manfred-hofmann/Wortuhr_ESP8266/Bau/Bau_Wortuhr_260x260.pdf

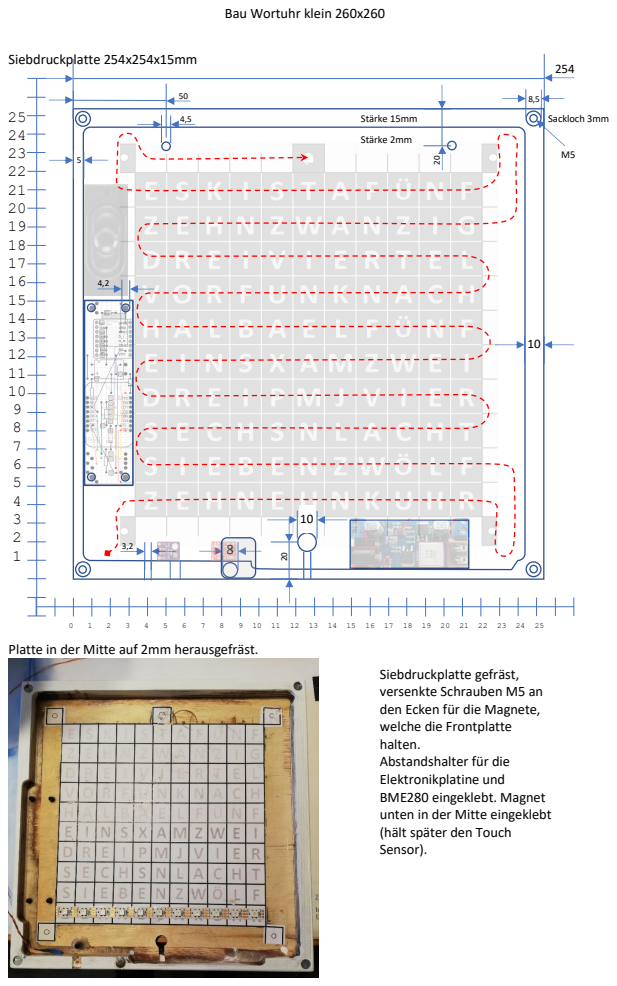
[picture p22: page 1]
Siebdruckplatte 254x254x15mm; Stärke 2mm; Stärke 15mm; Sackloch 3mm

Bau Wortuhr klein 260x260

Platte in der Mitte auf 2mm herausgefräst.

Siebdruckplatte gefräst,
versenkte Schrauben M5 an
den Ecken für die Magnete,
welche die Frontplatte
halten.
Abstandshalter für die
Elektronikplatine und
BME280 eingeklebt. Magnet
unten in der Mitte eingeklebt
(hält später den Touch
Sensor).

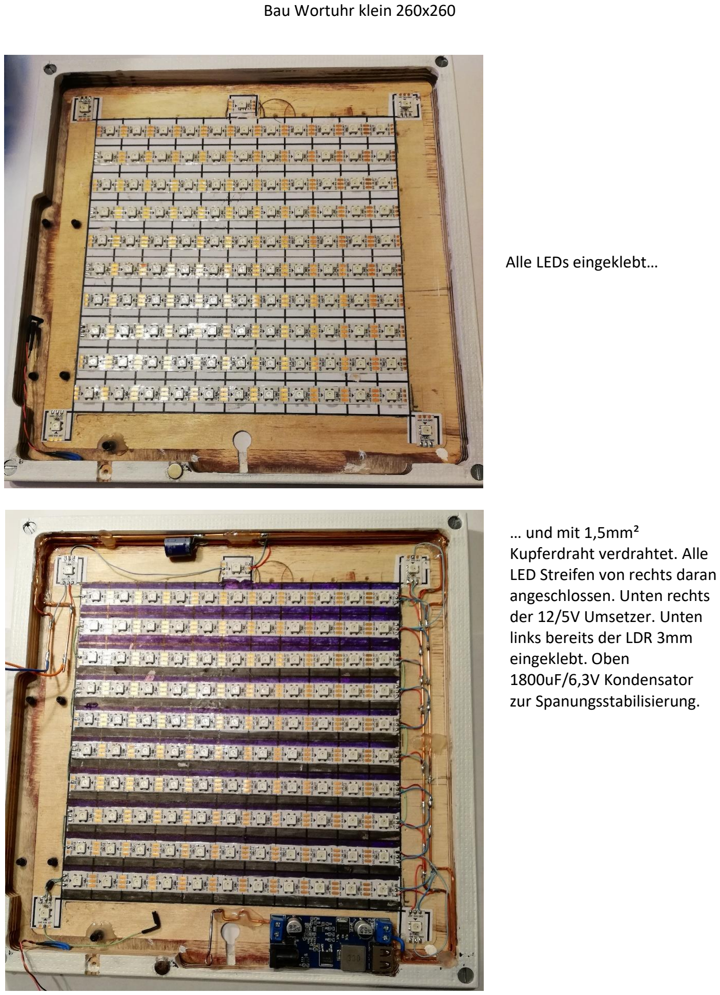
[picture p23: page 2]

Alle LEDs eingeklebt…

… und mit 1,5mm²
Kupferdraht verdrahtet. Alle LED Streifen von rechts daran angeschlossen. Unten rechts der 12/5V Umsetzer. Unten
links bereits der LDR 3mm
eingeklebt. Oben
1800uF/6,3V Kondensator
zur Spanungsstabilisierung.

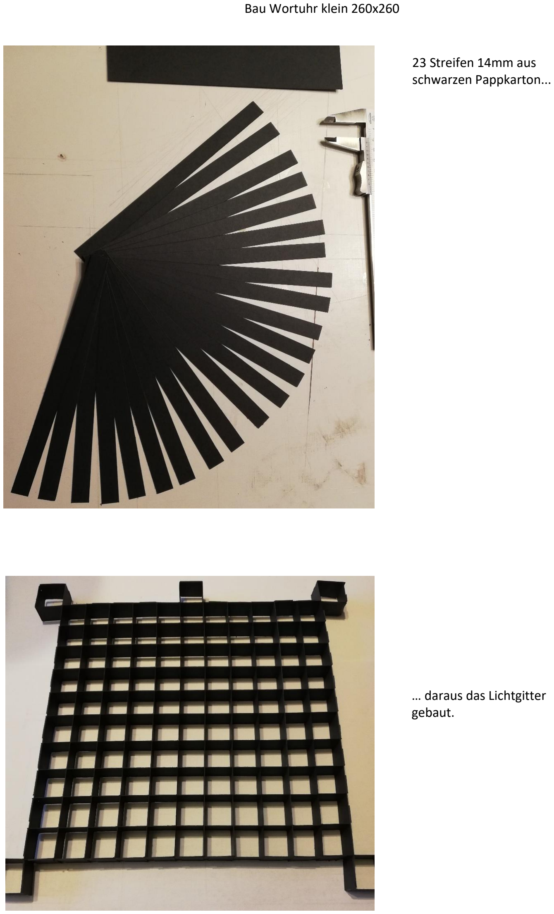
[picture p24: page 3]

23 Streifen 14mm aus
schwarzen Pappkarton...

… daraus das Lichtgitter
gebaut.

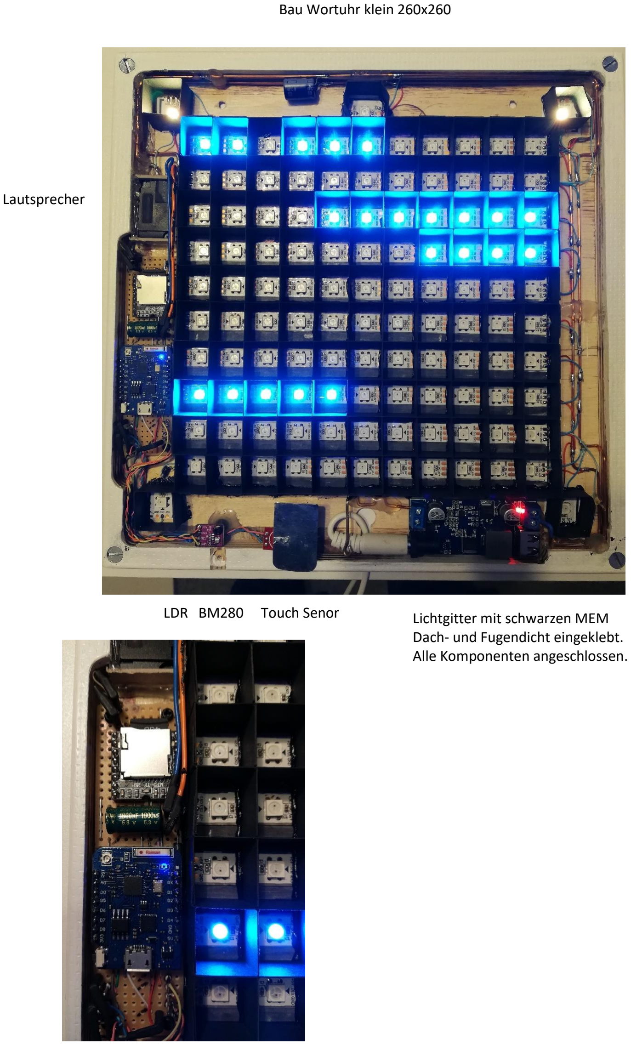
[picture p25: page 4]

Lichtgitter mit schwarzen MEM Dach- und Fugendicht eingeklebt. Alle Komponenten angeschlossen.

Lautsprecher

LDR BM280 Touch Senor

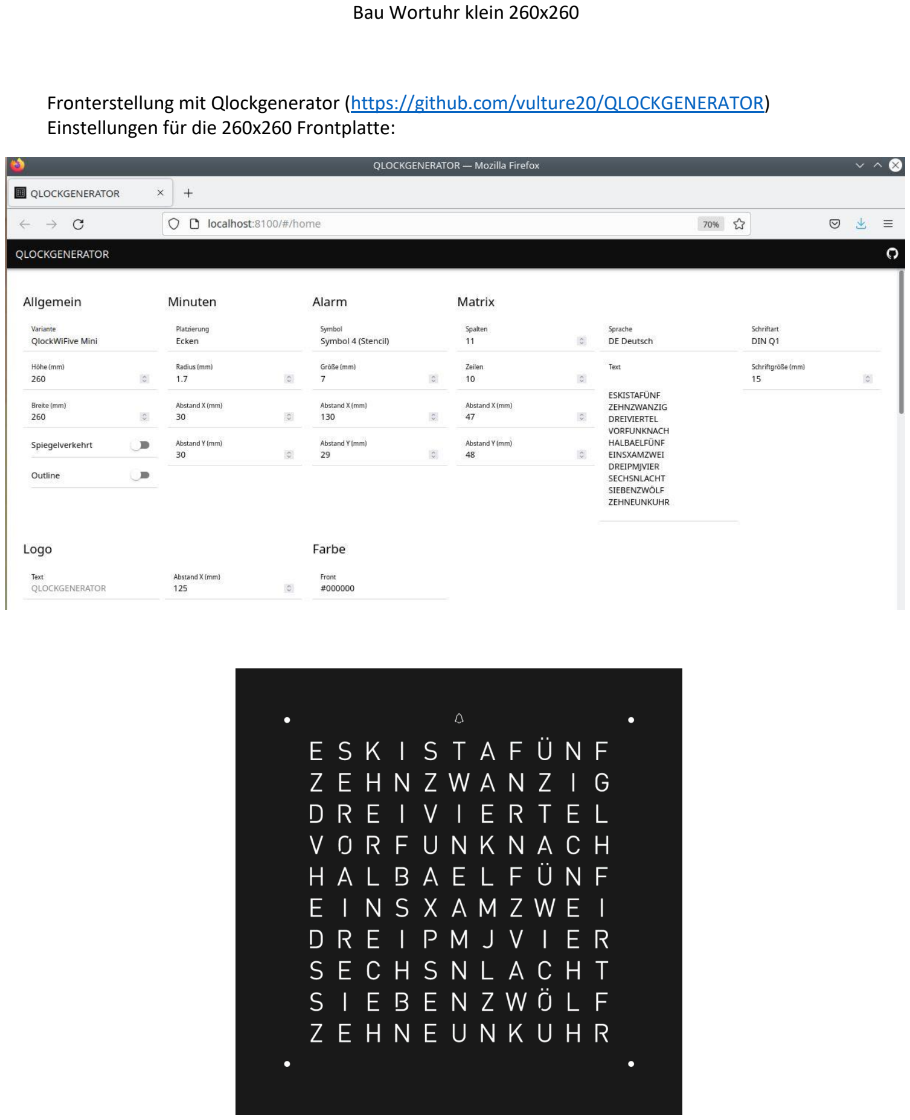
[picture p26: page 5]

Fronterstellung mit Qlockgenerator (https://github.com/vulture20/QLOCKGENERATOR) Einstellungen für die 260x260 Frontplatte:

Magnete an den Ecken der Rückseite der Frontplatte geklebt. Forder- und Rückseite matt lackiert. Transparentpapier mit Sprühkleber auf die Rückseite geklebt.

Fertige Uhr:

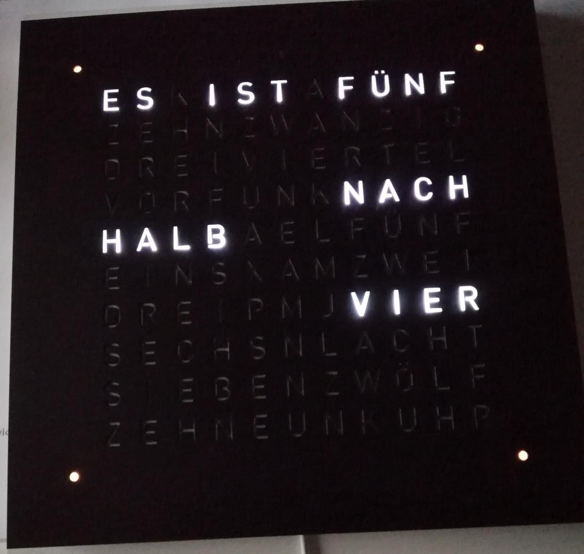
[picture p27: figure]

Bauteilliste:

Nr | Artikel | Web | Einzelpreis | Menge | Preis
1 | JZK® 24V/ 12V bis 5V 5A Power Buck Modul DC-DC Step Down Netzteil Konverter Board | Amazon (https://www.amazon.de/Power-Modul-DC-DC-Netzteil-Konverter/dp/B071ZRXKJY) | 6,59 | 1,00 | 6,59
2 | Intenso microSDHC 8GB Class 10 Speicherkarte | Amazon (https://www.amazon.de/Intenso-Micro-Class-Speicherkarte-SD-Adapter/dp/B008RDCCFS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) | 3,39 | 1,00 | 3,39
3 | Fotowiderstand PFW351, 3 mm, 5 Stück | Amazon (https://www.amazon.de/Pollin-Fotowiderstand-PFW351-St%C3%BCck/dp/B00H8O5MAE) | 1,49 | 0,20 | 0,30
4 | 50 Blatt Weiß Transparentpapier 90g DIN A4 210x297mm Golden Star, Pauspapier zum Bedrucken | Amazon (https://www.amazon.de/gp/product/B07N86TL8H/ref=ppx_yo_dt_b_asin_title_o09_s00) | 7,00 | 0,04 | 0,28
5 | Fotokarton, Bastelkarton schwarz, 50 Blatt, DIN A4, hochwertige Qualität, 300 g/m² | Amazon (https://www.amazon.de/dp/B01N0DPHI1/ref=pe_27091401_487024491_TE_item) | 8,95 | 0,04 | 0,36
6 | MEM Dach- und Fugendicht, Lösemittelfreie Bitumenmasse, Schwarz, 300 g | Amazon (https://www.amazon.de/gp/product/B002KLV98O/ref=ppx_yo_dt_b_asin_title_o00_s00) | 5,79 | 0,05 | 0,29
7 | Yizhet 50 Stück Magnete Ultra Magnet Supermagnete Haushaltsmagnete 8x3 mm | Amazon (https://www.amazon.de/gp/product/B074C79DJS/ref=ppx_yo_dt_b_search_asin_title?th=1) | 9,59 | 0,10 | 0,96
8 | DollaTek 5PCS TTP223 Touch-Key-Modul | Amazon (https://www.amazon.de/DollaTek-Touch-Key-Modul-Kapazitiv-Einstellbare-Self-Lock/dp/B07DK3DFR2) | 4,99 | 0,20 | 1,00
9 | Schaltnetzteil, Telekom, DA-24R12-AAAA,12V/2A, weiß oder Ähnliches | Pollin (https://www.pollin.de/p/schaltnetzteil-telekom-da-24r12-aaaa-12v-2a-weiss-352355) | 2,65 | 1,00 | 2,65
10 | Euro-Netzkabel mit Doppelnutkupplung, weiß, 1,5m | Pollin (https://www.pollin.de/p/euro-netzkabel-mit-doppelnutkupplung-weiss-1-5m-b-ware-563753) | 0,95 | 1,00 | 0,95
11 | Streifenraster-Platine, FR4, Epoxyd, 160x100 mm | Pollin (https://www.pollin.de/p/streifenraster-platine-fr4-epoxyd-160x100-mm-442501) | 3,85 | 0,20 | 0,77
12 | Lautsprecher-Set, L/R, 4 Ohm, 2,5 W oder alter Handylautsprecher | Pollin (https://www.pollin.de/p/lautsprecher-set-l-r-4-ohm-2-5-w-aus-laptop-641240) | 0,75 | 0,50 | 0,38
13 | Elektrolytkondensator, 1,8mF, 6,3V 10x16mm | Pollin (https://www.pollin.de/p/elektrolytkondensator-1-8mf-6-3v-210885) | 0,30 | 2,00 | 0,60
14 | Metallschicht-Widerstand, 0,6 W, 4,7kΩ, 1 % | Pollin (https://www.pollin.de/p/metallschicht-widerstand-0-6-w-4-7ko-1-221177) | 0,07 | 2,00 | 0,14
15 | Metallschicht-Widerstand, 0,6 W, 2,2kΩ, 1 % | Pollin (https://www.pollin.de/p/metallschicht-widerstand-0-6-w-2-2ko-1-221170) | 0,07 | 2,00 | 0,14
16 | Metallschicht-Widerstand, 0,6 W, 3,9 Ω, 1 % | Pollin (https://www.pollin.de/p/metallschicht-widerstand-0-6-w-3-9-o-1-221126) | 0,07 | 1,00 | 0,07
17 | Diode 1N4007, axial | Pollin (https://www.pollin.de/p/diode-1n4007-axial-140020) | 0,02 | 2,00 | 0,04
18 | Kupferdraht 0,3mm versilbert 10m | Pollin (https://www.pollin.de/p/kupferdraht-versilbert-560040) | 0,80 | 0,04 | 0,03
19 | Mini MP3 Modul DFPlayer Mini Besser Leiterkartenpiraten Player | AliExpress (https://de.aliexpress.com/item/32669547044.html?spm=a2g0o.9042311.0.0.43384c4dLeTun8) Leiterk (https://www.leiterkartenpiraten.de/produkt/lkp-player/) | 1,29 8,00 | 1,00 1,00 | 1,29 8,00
20 | WeMos D1 Mini ESP8266 WIFI Modul Entwicklung Bord Pro 16M Bytes | AliExpress (https://de.aliexpress.com/item/32669779651.html?spm=a2g0o.9042311.0.0.43384c4dLeTun8) | 6,48 | 1,00 | 6,48
21 | GY-BME280 Digital Sensor Temperatur Feuchtigkeit Luftdruck Sensor | AliExpress (https://de.aliexpress.com/item/32898592482.html?spm=a2g0o.9042311.0.0.43384c4dLeTun8) | 7,91 | 1,00 | 7,91
22 | 4m WS2812B RGB Led Streifen Schwarz PCB 5V 4m 60 IP30 | AliExpress (https://de.aliexpress.com/item/2036819167.html?spm=a2g0o.9042311.0.0.43384c4dLeTun8) | 15,42 | 0,50 | 7,71
23 | Siebdruckplatte 254x254x15 | Baumarkt | 6,00 | 1,00 | 6,00
24 | Frontplatte Acrylglas GS Präzisison schwarz, opak Stärke 1 mm 790 x 384 mm = 3 x Front | Formulor | 118,77 | 0,33 | 39,59
25 | Kleinteile (Schrauben, Sprühkleber, Farbe, 1,2m Kupferdraht 1,5mm² u.s.w) | Baumarkt | 12,00 | 1,00 | 12,00
Summe: | 99,91
