manfred-hofmann/Wortuhr_ESP8266/pic/spiffs2.JPG

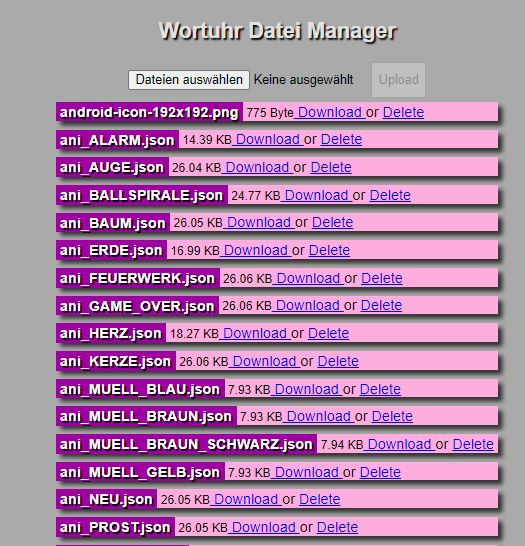
pic/spiffs2.JPG
