manfred-hofmann/Wortuhr_ESP8266/src/data/web/web_01na.png

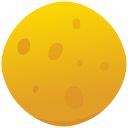
src/data/web/web_01na.png
