manfred-hofmann/Wortuhr_ESP8266/src/data/web/web_02na.png

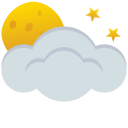
src/data/web/web_02na.png
