manfred-hofmann/Wortuhr_ESP8266/src/data/web/web_10na.png

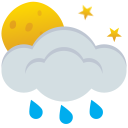
src/data/web/web_10na.png
