manfred-hofmann/Wortuhr_ESP8266/src/data/web/web_10nb.png

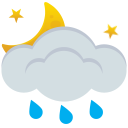
src/data/web/web_10nb.png
