manfred-hofmann/Wortuhr_ESP8266/src/data/web/web_11.png

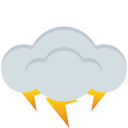
src/data/web/web_11.png
