manfred-hofmann/Wortuhr_ESP8266/(threads)

Thread 5 (2022-01-02):

Keine Daten vom BME_280

Phi2ipp, 2022-01-02:
Hallo,

ich verwende den 6 Pin (VCC, GND, SCL, SDA, CSB, SDO) BME 280 Sensor.
Diesen habe ich wie im Schaltplan angeschlossen, aber leider spuckt er keine Daten aus.
Auf der Info-Seite des ESP8266 werden es immer mehr "Error (BME): 60"

Kannst du mir hier weiterhelfen?

manfred-hofmann, 2022-01-03:
Ich glaube du musst hier noch zusätzlich den CSB Pin auf VCC (3,3V) legen.

Phi2ipp, 2022-01-03:
Das bringt leider keine Veränderung.
Wird wohl der Sensor defekt sein.

manfred-hofmann, 2022-01-03:
Evtl. stimmt die Adresse auch nicht. Schau mal ins Datenblatt. Mit SD0 wird zwischen 0x76 und 0x77 umgeschaltet. Ich glaub für die default Adresse des BME280 muss der SD0 auf Masse liegen. Oder mach mal mit einem Scan Programm einen I2c scan, ob dein BME280 gefunden wird.

Phi2ipp, 2022-01-03:
Der BME280 wird nicht im I2C gefunden. Ich vermuter er ist defekt.
Werde mir einen neuen besorgen und es noch mal testen.

manfred-hofmann, 2022-01-03:
👍

Closed 2022-01-03.

Thread 7 (2022-02-28):

16x16 LED Matrix support?

bmk666, 2022-02-28:
Hi Manfred,

erst mal vielen dank für das tolle Projekt!

Wäre es Möglich eine fertige 16x16 LED Matrix zu verwenden?

z.B. [Link](https://www.amazon.de/HER-WS2812B-Flexible-Individually-addressable/dp/B08DVBGRRL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)

Das würde das Bauen einer solchen Uhr extrem vereinfachen!

Und man könnte vielleicht die zusätzlichen Pixel für Sekunden nehmen wie z.B. bei dem Projekt:
[Link](https://www.thingiverse.com/thing:5073594)

Danke und viele Grüße,

Sascha

manfred-hofmann, 2022-02-28:
Hallo Sascha,
möglich ist viel.
Jedoch ist die 16x16 Matrix schon sehr klein.
Du musst einfach die LED Matrix in LedDriver.cpp entsprechend anpassen. Ist unten in der Readme auf der Hauptseite erklärt.
Ein "Sekundenzeiger" ist aktuell nicht vorgesehen.
Gruß
Manfred

bmk666, 2022-02-28:
Hi,

Ja von wegen der Größe ist es mehr was für den Schreibtisch, nicht für die Wand!
Nochmals danke!

Grüße,
Sascha

Closed 2022-02-28.

Thread 8 (2022-04-15):

RTC Modul

LeifGitHub, 2022-04-15:
Ein wirklich unglaubliches Projekt. Hast du bereits über die Integration einer RealTimeClock nachgedacht, sodass man die Uhr nur zum aufsetzten mit WiFi betreiben muss?

manfred-hofmann, 2022-04-15:
Ohne WiFi macht die Uhr keinen Sinn, da dann das Web frontend und open weather nicht mehr funktionieren. Außerdem sollte doch inzwischen jeder ein WLAN zu Hause haben.
Gruß

LeifGitHub, 2022-04-15:
Vielen Dank für die schnelle Antwort. Ich hatte an ein Fallback falls das Internet ausfällt gedacht, auch würde das Modul und der Traffic weniger belastet? An manchen Orten gibt es zudem auch nur stark gesicherte Wifis oder es wird mit temporären HotSpots agiert. Wie könnte sowas denn integriert werden, wäre über Hinweise dankbar! Vermutlich doch eine, RTC Library hinterlegen, den Verweis auf die RTC und nicht den Zeitserver, nur beim booten/ Neustart gucken ob Internet vorhanden ist und wenn möglich die Zeit aktualisieren?

manfred-hofmann, 2022-04-15:
Auch wenn das I-Net über mehrere Stunden ausfällt, hält der ESP die Uhrzeit sehr genau. Einen Ausfall des Internets über mehrere Tage hatte ich noch nicht. Ein RTC Modul ist trotzdem in der SW vorgesehen. Siehe Configuration.h Es gibt einige Leute, die betreiben die Uhr mit RTC MODUL (z. B. espuno siehe Wortuhrforum)
Gruß

LeifGitHub, 2022-04-15:
Vielen Dank!

Closed 2022-04-15.

Thread 9 (2022-11-13):

Problem mit Fronplatte ?

interceptor70, 2022-11-13:
Erstmal ganz wichtig ein super Projekt 😊
Aber leider stehe ich auf dem schlauch wegen der frontplatte,
Die ich aus einem alten Project habe.

Wie bekomme ich das hin das die Buchstaben wieder passen ?
Erstmal ganz wichtig ein super Projekt 😊
Aber leider stehe ich auf dem schlauch wegen der frontplatte,
Die ich aus einem alten Project habe.

Wie bekomme ich das hin das die Buchstaben wieder passen ?

p.s. start led rechts unten

untersten symbole sind die minuten

lg Gerrit
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

manfred-hofmann, 2022-11-14:
Hallo Gerrit,
schau mal hier auf der Startseite unten ist erklärt wir das mit dem Layout funktioniert.
Gruß
Manfred

interceptor70, 2022-11-14:
Das ist ja mein Problem das kann ich ja ändern.
Die Reihenfolge ändern ist ja nicht das problem…. Lach

Die worte passen nicht zusammen weil ich eine 11 x 11 Matrix habe.

Vom panbachi aber leider ist die nicht so schön bunt wie deine version 😊

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

interceptor70, 2022-11-15:
Dann schaut das ja so aus,
wenn ich das richtig verstehe oder ?

aber die Wörter passen dann nicht wie kann ich die verschieben oder wo ?

> #ifdef LED_LAYOUT_VERTICAL_3
    uint8_t ledMap[] = {
        120, 119, 118, 117, 116, 115, 114, 113, 112, 111, 110,
        109, 108, 107, 106, 105, 104, 103, 102, 101, 100,  99,
         98,  97,  96,  95,  94,  93,  92,  91,  90,  89,  88,
         87,  86,  85,  84,  83,  82,  81,  80,  79,  78,  77,
         76,  75,  74,  73,  72,  71,  70,  69,  68,  67,  66,
         65,  64,  63,  62,  61,  60,  59,  58,  57,  56,  55,
         54,  53,  52,  51,  50,  49,  48,  47,  46,  45,  44,
         43,  42,  41,  40,  39,  38,  37,  36,  35,  34,  33,
         32,  31,  30,  29,  28,  27,  26,  25,  24,  23,  22,
         21,  20,  19,  18,  17,  16,  15,  14,  13,  12,  11,
         2,  4,  5,  6,  8
    };
#endif

manfred-hofmann, 2022-11-15:
Du hast 2 Probleme
1. Du hast 121 Leds
2. Deine Worte passen nicht.
zu 1
Du kannst versuchen in configuration.h die NUMPIXELS auf 121 zu setzen. Dann solltest du deine LEDs Layout anpassen können.
zu 2
Die Wörter werden in Words.h definiert.
Hier musst du halt jedes Wort an dein Layout anpassen.

manfred-hofmann, 2022-11-15:
OK, hört sich gut an.
Es wird bald ein neues Release rauskommen. Ich habe alles auf LittleFS umgestellt. Spiffs ist ja deprecated.
Und noch ein paar andere Änderungen.

interceptor70, 2022-11-15:
Jup das cool

Also erstmal die 11 x 11
Panabacht ... matrix siehe oben (einspeisung unten rechts)

`#define DE_VOR				matrix[3] |= 0b0000001110000000
#define DE_NACH				matrix[3] |= 0b0011110000000000
#define DE_ESIST			matrix[0] |= 0b1101110000000000
#define DE_UHR				matrix[9] |= 0b0000000011100000
#define DE_AM				matrix[5] |= 0b0000011000000000
#define DE_PM				matrix[6] |= 0b0000110000000000

#define DE_FUENF			matrix[0] |= 0b0000000111100000
#define DE_ZEHN				matrix[1] |= 0b1111000000000000
#define DE_VIERTEL			matrix[2] |= 0b0000111111100000
#define DE_ZWANZIG			matrix[1] |= 0b0000111111100000
#define DE_HALB				matrix[4] |= 0b1111000000000000
#define DE_DREIVIERTEL		matrix[2] |= 0b1111111111100000

#define DE_H_EIN			matrix[5] |= 0b0011100000000000
#define DE_H_EINS			matrix[5] |= 0b0011110000000000
#define DE_H_ZWEI			matrix[5] |= 0b1111000000000000
#define DE_H_DREI			matrix[6] |= 0b0011110000000000
#define DE_H_VIER			matrix[7] |= 0b0000000111100000
#define DE_H_FUENF			matrix[6] |= 0b0000000111100000
#define DE_H_SECHS			matrix[9] |= 0b0111110000000000
#define DE_H_SIEBEN			matrix[5] |= 0b0000011111100000
#define DE_H_ACHT			matrix[8] |= 0b0111100000000000
#define DE_H_NEUN			matrix[7] |= 0b0001111000000000
#define DE_H_ZEHN			matrix[8] |= 0b0000011110000000
#define DE_H_ELF			matrix[7] |= 0b1110000000000000
#define DE_H_ZWOELF			matrix[4] |= 0b0000011111000000
`
und das LED_Layout

`    uint8_t ledMap[] = {
        120, 119, 118, 117, 116, 115, 114, 113, 112, 111, 110,
         99, 100, 101, 102, 103, 104, 105, 106, 107, 108, 109,
         98,  97,  96,  95,  94,  93,  92,  91,  90,  89,  88,
         77,  78,  79,  80,  81,  82,  83,  84,  85,  86,  87,
         76,  75,  74,  73,  72,  71,  70,  69,  68,  67,  66,
         55,  56,  57,  58,  59,  60,  61,  62,  63,  64,  65,
         54,  53,  52,  51,  50,  49,  48,  47,  46,  45,  44,
         33,  34,  35,  36,  37,  38,  39,  40,  41,  42,  43,
         32,  31,  30,  29,  28,  27,  26,  25,  24,  23,  22,
         11,  12,  13,  14,  15,  16,  17,  18,  19,  20,  21,
         8, 6, 4, 2,  0
    };`

GANZ WICHTIG :-) die anzahl der LED´s nicht vergessen
 configuration.h die NUMPIXELS auf 121

lg Gerrit

interceptor70, 2022-11-15:
> OK, hört sich gut an. Es wird bald ein neues Release rauskommen. Ich habe alles auf LittleFS umgestellt. Spiffs ist ja deprecated. Und noch ein paar andere Änderungen.

hoffentlich was mit Sound das bekomme ich jetzt nicht ans drehen.

> error: no matching function for call to 'SoftwareSerial::SoftwareSerial(const uint8_t&, const uint8_t&, bool, int)'

manfred-hofmann, 2022-11-15:
Mach mal bei
`SoftwareSerial SoftSer(PIN_AUDIO_TX, PIN_AUDIO_RX, false, 128); `
Die 128 weg.
Also nur
`SoftwareSerial SoftSer(PIN_AUDIO_TX, PIN_AUDIO_RX, false);`

interceptor70, 2022-11-16:
Hmm ,
irgendwo was vergessen glaube ich...

> Wortuhr_mp3:136:28: error: 'AUDIO_BASENR0' was not declared in this scope
>   136 | int16_t SOUNDBASENR[17] = {AUDIO_BASENR0,AUDIO_BASENR1,AUDIO_BASENR2,AUDIO_BASENR3,AUDIO_BASENR4,AUDIO_BASENR5,
>

interceptor70, 2022-11-19:
Ich bastel gerade ein Layout, zum selber Ätzen, die Real Time Clock hattest du ja auch vorgesehen
am gleichen I2C Bus oder Separat ?

LG Gerrit

manfred-hofmann, 2022-11-20:
RTC brauchst du nicht. Der ESP ist genau genug, wenn jede Stunde die Zeit vom NTP Server geholt wird.

Closed 2022-11-20.

Thread 11 (2023-01-22):

Probleme mit der ersten LED

MikeTsenatek, 2023-01-22:
Hallo,

ich hab leider probleme mit der ersten LED. Diese ist bei mir eine Minuten LED. (Aus Historischen Gründen, ich hab früher eine andere Firmware drauf)

`#ifdef LED_LAYOUT_HORIZONTAL_4
uint8_t ledMap[] = {
  4, 5, 6, 7, 8, 9, 10, 11, 12, 13, 14,
  25, 24, 23, 22, 21, 20, 19, 18, 17, 16, 15,
  26, 27, 28, 29, 30, 31, 32, 33, 34, 35, 36,
  47, 46, 45, 44, 43, 42, 41, 40, 39, 38, 37,
  48, 49, 50, 51, 52, 53, 54, 55, 56, 57, 58,
  69, 68, 67, 66, 65, 64, 63, 62, 61, 60, 59,
  70, 71, 72, 73, 74, 75, 76, 77, 78, 79, 80,
  91, 90, 89, 88, 87, 86, 85, 84, 83, 82, 81,
  92, 93, 94, 95, 96, 97, 98, 99, 100, 101, 102,
  113, 112, 111, 110, 109, 108, 107, 106, 105, 104, 103,
  2, 1, 0, 3
};
#endif`

Leider geht die erste LED nur sehr sporatisch (v.a. nach der Änderung der Helligkeit in den Settings).

Hardware Defekt kann ich ausschließen, ich hab zum Testen eine andere Software (erst selbstgeschrieben, danach WLED) installiert, bei beiden funktioniert die LED einwandfrei.

Die LED 2,1, und 3 gehen einwandfrei.

Gibt es irgendeine Idee, wo ich suchen könnte.

VG
Philipp

manfred-hofmann, 2023-01-22:
Hallo Philipp,
Du kannst mal versuchen den Eintrag 0 mit z. B. 1,2 oder 3 zu tauschen und schauen ob der Fehler mitwandert.

Hast du die Versionen alle geprüfte?
Besonders die neuestes Version von Adafruit NeoPixel (Version 1.10.6) installiert?

WLED benutzt die FastLED Library!
Gruß
Manfred

MikeTsenatek, 2023-01-22:
Hallo Manfred,

ich benutzte die 1.10.7 von NeoPixel.
Wenn ich die 2,1,0,3 ändere, es bleibt immer die gleiche LED (die 0er) aus.

VG
Philipp

manfred-hofmann, 2023-01-22:
Hallo Philipp,
Du kannst mal die Matrix Tests oder den Animationseditor starten. Da sind die Minuten LEDs dauerhaft an.
Wenn es immer die erste LED ist, kann es auch daran liegen, das der Pegel  nicht ganz ausreicht. Der sollte mind. 70% der Versorgungsspannung sein. Das sind bei 5V 3,5V. Da kannst du mal versuchen die erste LED mit einer Diode zwischen der Stromzuführung zu versorgen. Dann ist die Versorgungsspannung der erste LED 4,5V. Also 3,15V für high Pegel. Ich hatte auch schonmal eine LED mit thermischen Problem. Da gingen aber auch alle nachfolgenden LEDs nicht mehr.
Kannst du mal die LED mal tauschen, oder diese auslassen und mit der Einspeisung bei der zweiten beginnen?

Gruß
Manfred

MikeTsenatek, 2023-01-23:
Hallo Manfred,

hab jetzt folgendes probiert:
1) kleiner Sketch mit allen LEDs an in random Farbe mit Neopixel => LED geht
2) LED getauscht
3) Pegelwandler eingesetzt (Mosfet, zwei Widerstände)
4) Wemos getauscht
5) Matrix Test => LED geht
6) Tetris => LED geht

Die LED geht überall, nur nicht mit dem Wordclock Sketch. Langsam bin ich echt überfragt.

Was mir noch eingefallen ist, anfangs hatte ich die ESP32 Version drauf (hatte diese hier erst später entdeckt), hier lief die LED auch.

VG
Philipp

MikeTsenatek, 2023-01-23:
Glaub ich hab den Fehler....

meine ledmap war keine Konstante...

Sry für die Beschäftigung

MikeTsenatek, 2023-01-23:
Hmm, jetzt hab ich einen anderen Bug.

Jetzt geht im Uhrenmodus die 12. LED nicht (das Ü in der 1. Zeile).

Beim Matrixtest funktioniert sie, aber beim Anzeigen der 5. Zeile leuchtet zusätzlich mit.

MikeTsenatek, 2023-01-23:
Glaub auch da war ich Schuld..., es fehlte eine 115. LED in der LEDMap, auch wenn ich keine Angeschlossen hab.

Gibt es irgendwo ein https://www.buymeacoffee.com/ Link o.ä.?

Ich schließe es hier

Closed 2023-01-23.

Thread 12 (2023-03-30):

WLAN Probleme

xpilzx1, 2023-03-30:
Hallo zusammen,
Hallo Manfred,
Zuerst einmal Danke für die viele Arbeit die in diesem Projekt steckt, und dafür das es und frei zur Verfügung gestellt wird.
Ich habe da ein Problem mit der WLAN Verbindung. Ich habe die Audiofunktion sowie die IR Fernbedinung auskommentiert. Die Uhr läuft etwa 10 bis 20h wie sie soll, und dann irgendwann geht die Verbindung verloren.
Über die Website ist Sie auch nicht zu erreichen, aber es wird wieder ein WLAN zur Verfügung gestellt.
In dem Netz können aber nicht die wlandaten eingegeben werden, sondern es wird die Website unter der standart IP aufgerufen.
Da die Inet Verbindung fehlt bleibt die Uhrzeit stehen und die Wetter API ohne Inhalt.
Ich weiss leider nicht weiter. Jemand eine Idee??

manfred-hofmann, 2023-03-30:
Was passiert, wenn du den ESP neu startest?

xpilzx1, 2023-03-31:
Rebot und aus / ein bringen keine Änderung. Die Website ist nur unter der Standard IP zu erreichen. Ein wifireset ermöglicht es wieder die Routerdaten einzugeben und dann läuft das ganze wieder für ein paar Stunden.

manfred-hofmann, 2023-03-31:
Wenn ich das richtig verstehe, macht der ESP immer nur einen AP auf. D.h. beim Neustart wird das WiFi Symbol nicht grün! Schaltest du dein WLAN z.B. nachts aus?
Kannst Du mal Versuchen alles neu mit der Board Version 3.0.2 zu laden.

xpilzx1, 2023-03-31:
Ja so ist es ä. Er macht immer einen AP auf und vergisst die IP. Mein WLAN läuft durch, und ich habe das ganze schon mit V3.0.2 geladen.
Ich nutze ein D1 Pro .
Ich habe mir auch überlegt den AP einfach abzuschalten, und SSID sowie PW meines Netzes einfach Fix zu hinterlegen.
Leider reichen meine Arduinomoves nicht aus. Ich konnte die Stelle mit der WIFI Verbindung nicht im Code finden.

manfred-hofmann, 2023-03-31:
Das ist alles sehr merkwürdig. Evtl. hat dein ESP ein Problem. Normalerweise werden SSID und PW dauerhaft im Flash gespeichert und nur durch wifireset gelöscht. Die Stelle, wo die WiFi Verbindung gestartet wird findest du im Code wenn du nach  "WiFiManager wifiManager;" suchst.

xpilzx1, 2023-04-03:
Ich denke ich habe die Lösung gefunden. So wie es ausschaut waren Sonderzeichen in der SSID das Problem. Nachdem ich die Uhr Testweise mit meinem Gastnetz verbunden hatte lief Sie tadellos.
Noch ist zwar nicht viel Zeit vergangen, aber Sie läuft jetzt schon über 40h am Stück.  Und auch das wiederverbinden nach einem netzwerkausfall geht deutlich schneller und problemloser .
Vielen Dank nochmal

Closed 2023-04-03.

Thread 13 (2023-04-11):

Compilierungsfehler variable or field 'setMode' declared void

WRT0815, 2023-04-11:
Hallo,
ich bin totaler Anfänger in der Programmierung, fand das Projekt aber super spannend zum nachbauen.

Leider scheitere ich jetzt bereits beim compilieren der SW in Arduino IDE.

Ich bekomme  Compilierungsfehler immer wo "setMode()" aufgerufen wird.
Hier die Stelle an der das zum ersten Mal auftritt:
...
... Arduino\Wortuhr_esp\Wortuhr_mp3.ino:1081:7: error: 'setMode' was not declared in this scope; did you mean 'eMode'?
 1081 |       setMode(MODE_BLANK);
      |       ^~~~~~~
      |       eMode
...
Compilation error: variable or field 'setMode' declared void...

Kann mir hierzu vielleicht jemand einen Tipp geben? Gut möglich dass das Problem vor dem Computer sitzt in meinem Fall.
Was könnte denn das Problem sein.

Ich nutze Arduino IDE 2.0.4 hatte auch schon was gelesen, dass es special effexcts geben kann beim Compilieren je nach Version.

Ich habe am Code nichts geändert.
Lediglich im Config File die APIKEY für das Wetter auskommentiert. (ist aber irrelevant für das Problem)

Gruß Tobias

manfred-hofmann, 2023-04-12:
Evtl. liegt es an der Arduino IDE. Ich verwende immer noch die 1.8.X Version. Die scheint ein wenig genügsamer zu sein.

WRT0815, 2023-04-12:
Hallo danke für die schnelle Rückmeldung. Ich hab das nochmal in Ruhe alles neu gemacht zunächst mit der IDE 1.8.x danach mit der aktuellen 2.0.4 und jetzt konnte ich compilieren und uploaden (auch mit 2.0.4). Also das Problem war wohl ich selbst. Glaube ich hatte im Sketch noch versehentlich eine alte Datei mit drin.
Jetzt wo der ESP läuft werde ich die Hardware aufbauen. Nochmal lieben Dank. Super Projekt.

Closed 2023-04-12.

Thread 14 (2023-05-30):

OTA Update firmware

BrunoMerz, 2023-05-30:
Hallo Manfred,
großartig Software! Ich habe selbst Software für eine Wortuhr entwickelt aber nicht so umfangreich. Zwei Funktionen vermisse ich.
1. Firmware Update per OTA
2. Wifi Connection per WPS Taste am Router

Zu OTA habe ich Code Passagen in deinem repo gesehen aber noch nicht verstanden

Gibt es die Möglichkeit schon?

Viele Grüße
Bruno

manfred-hofmann, 2023-05-30:
Hi Bruno,
OTA funktioniert natürlich.
WPS geht glaube ich nicht. Ich verwende den WiFiManager.
Gruß
Manfred

bracci, 2023-05-30:
Hallo Bruno,

beides geht in folgender Wortuhr-Firmware:
https://github.com/bracci/Qlockwork

Diese bedient sich derselben Code-Basis, enthält jedoch nur paar wenige
(z.B. die Animationen), der von Manfred entwickelten Zusatzfeatures.

Schau sie dir gerne mal an. Diskussion im Forum ist hier eröffnet:
http://diskussion.christians-bastel-laden.de/viewtopic.php?t=4230

Gruss,
Manuel

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
--
Mit freundlichen Grüssen

Manuel Bracher

Stegmattstrasse 14
3457 Wasen
Schweiz

+41 79 408 99 19

manfred-hofmann, 2023-06-02:
Ich denke die Frage ist beantwortet.

Closed 2023-06-02.

Thread 15 (2023-11-19):

Themes für das Frontend?

c64emulator, 2023-11-19:
Die jetzige Gestaltung des Frontends ist nicht jedermans Geschmack. Da wären Themes ganz cool. Vor allem sollten solche Einstellungen auch nach einem Update erhalten bleiben und ggf. auch ein Backup möglich sein.
Ein Dark Theme wäre z.B. ganz gut, würde sich besonders gut auf einem Handy mit AMOLED-Display (die haben aus Energiespar-Gründen oft ein Dark Theme eingestellt) machen.

manfred-hofmann, 2023-11-22:
Mir gefällt das Frontend. Jedoch kann jeder die css Files nach belieben ändern. Es ist ja auch nicht so, dass man das Frontend täglich benötigt um mit einem Dark Modus Energie zu sparen. Zumal die Uhr selbst ja nicht gerade Energiesparend ist.

Closed 2023-11-22.
