manfred-hofmann/Wortuhr_ESP8266/Platine_Plan_Wortuhr_mp3.pdf

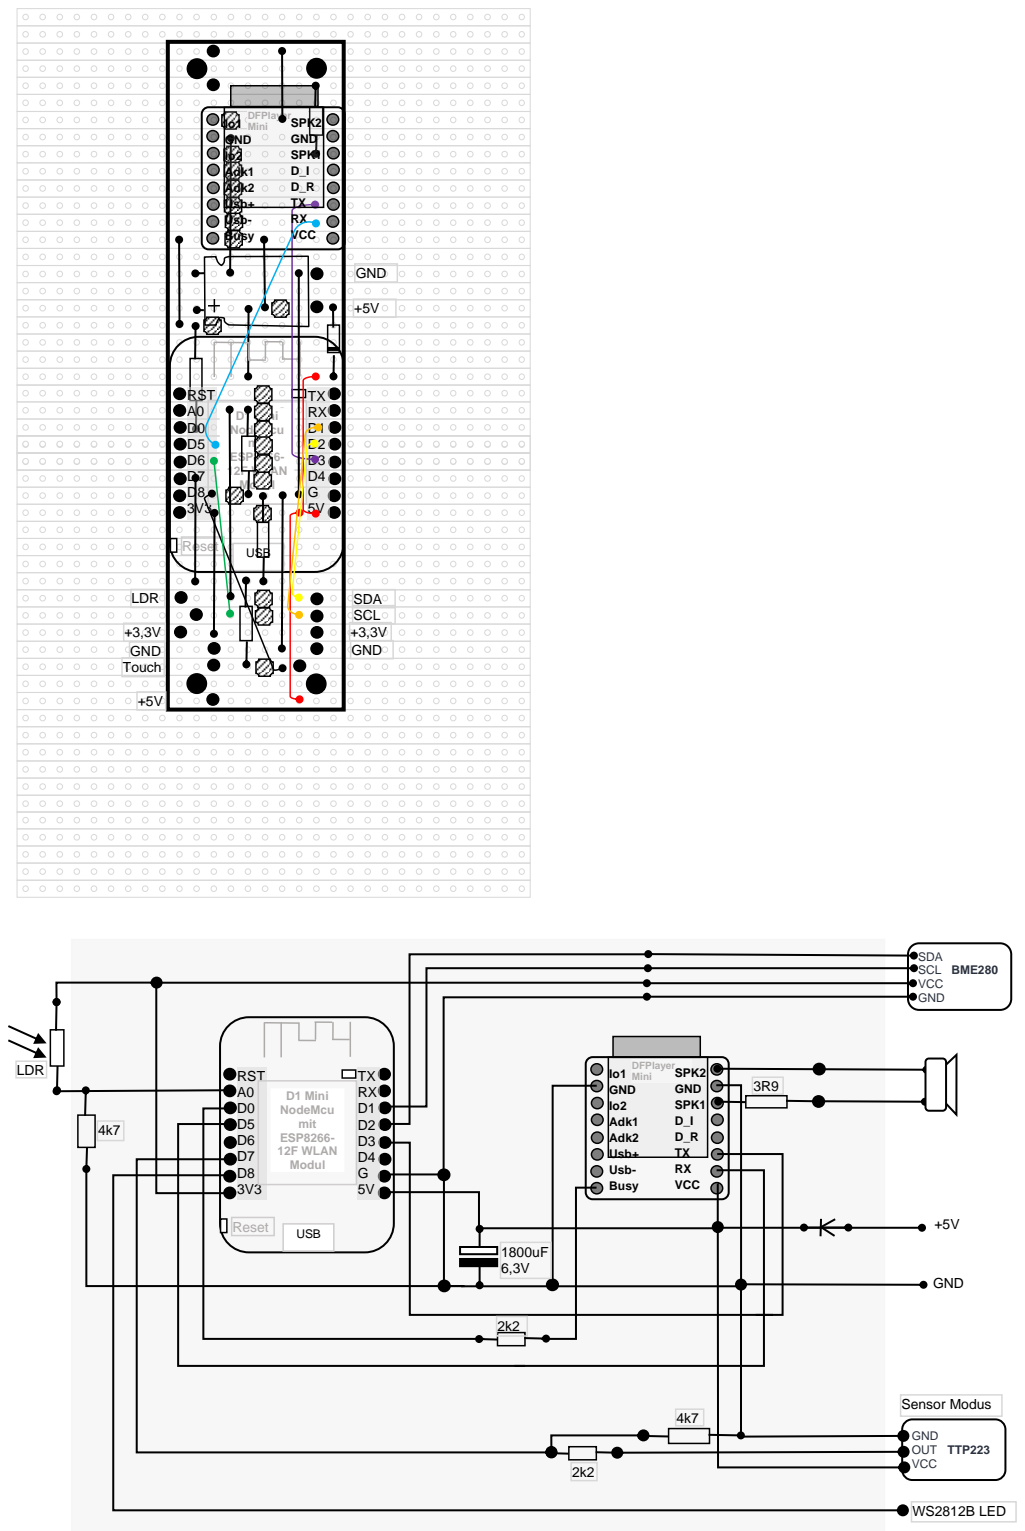
[picture p91: page 1]
