manfred-hofmann/Wortuhr_ESP8266/src/Wortuhr_mp3.ino

// ******************************************************************************
// WORTUHR_MP3
// An advanced firmware for a DIY "word-clock"
//
// @mc ESP8266 Version 3.0.2
// @created 12.03.2017
//
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
// ******************************************************************************
// ******************************************************************************

// Einstellungen für das Board: "LOLIN(WEMOS) D1 R2 & mini"
// CPU Frequenz auf 160 MHz
// Flash Size 4MB ( FS:2MB OTA~1019KB)
// SLL Support Basic

// oder für ESP8266 EX: Board: "LOLIN(WEMOS) D1 mini pro"
// CPU Frequenz auf 160 MHz
// Flash Size: 16MB ( FS:14MB OTA~1019KB)
// SLL Support Basic

// wichtig: Board Version >= 3.0.2

// Im Normalbetrieb immer alle DEBUG Schalter aus. (configuration.h ab Zeile 375!)

//########################################################################################################
// folgende Libraries werden benötigt:

//Arduino_JSON
//Open your Arduino IDE and go to Sketch > Include Library > Manage Libraries. The Library Manager should open.
//Search for “Arduino_JSON” on the Search box and install the library. Version 0.1.0 --> Arduino_JSON.h

// MP3-Player:
//https://wiki.dfrobot.com/DFPlayer_Mini_SKU_DFR0299
// Link zur Library: https://github.com/DFRobot/DFRobotDFPlayerMini/archive/1.0.5.zip -->DFRobotDFPlayerMini.h

//BME280:
//Open your Arduino IDE and go to Sketch > Include Library > Manage Libraries. The Library Manager should open.
//Search for “adafruit bme280 ” on the Search box and install the library Version 2.1.4. --> Adafruit_BME280.h
//To use the BME280 library, you also need to install the Adafruit_Sensor library. Follow the next steps to install the library in your Arduino IDE:
//Go to Sketch > Include Library > Manage Libraries and type “Adafruit Unified Sensor” in the search box.
//Scroll all the way down to find the library and install it (Version 1.1.4). --> Adafruit_Sensor.h

// Adafruit Neopixel:
//In the Arduino IDE, navigate to Sketch > Include Library > Manage Libraries
//Then the Library Manager will open and you will find a list of libraries that are already installed or ready for installation.
//Then search for Neopixel strip using the search bar.
//Click on the text area and then select the specific version 1.10.6 and install it. (mind. 1.10.6 bei Board >= 3.0.2) --> Adafruit_NeoPixel.h

// SunRise Library:
//In the Arduino IDE, navigate to Sketch > Include Library > Manage Libraries
//Then the Library Manager will open and you will find a list of libraries that are already installed or ready for installation.
//Then search for SunRise using the search bar.
//Click on the text area SunRise by Cyrus Rahman and then select the specific Version 2.0.2 and install it. --> SunRise.h

//ArduinoOTA 1.0.3                               --> ArduinoOTA.h
//TimeLib 1.6.0 by Michael Margolis              --> TimeLib.h
//Ticker 4.4.0 by Stefan Staub                   --> Ticker.h
//DFRobotDFPlayerMini 1.0.5 DFRobot (siehe oben) --> DFRobotDFPlayerMini.h


//optional:
//IRremoteESP8266 2.7.4 by David Conran,..
//DS3232RTC by Jack Christensen Version 2.0.1

//########################################################################################################

#define FIRMWARE_VERSION 20221222

//########################################################################################################

#include <Arduino.h>
#include <Arduino_JSON.h>
#include <ArduinoHttpClient.h>
#include <ArduinoOTA.h>

#include <Wire.h>
#include <SPI.h>
#include <Adafruit_Sensor.h>
#include <Adafruit_BME280.h>

#include <ESP8266HTTPUpdateServer.h>
#include <ESP8266mDNS.h>
#include <ESP8266WebServer.h>
#include <ESP8266WiFi.h>

#include <TimeLib.h>
#include <Ticker.h>
#include <LittleFS.h>

#include <SoftwareSerial.h>
#include <DFRobotDFPlayerMini.h>

#include "Configuration.h"


//IR_RECEIVER
#ifdef IR_RECEIVER
#include <IRremoteESP8266.h>
#include <IRrecv.h>
#include <IRutils.h>
#endif

//RTC_BACKUP
#ifdef RTC_BACKUP
#include <DS3232RTC.h>
#endif

// LED-Stripe Typ
#ifdef LED_LIBRARY_NEOPIXEL
#include "LedDriver.h"
#endif

#ifdef LED_LIBRARY_LPD8806RGBW
#include "LedDriver_LPD8806RGBW.h"
#endif


#include "Colors.h"
#include "Events.h"
#include "spiel_main.h"
#include "Languages.h"
#include "Modes.h"
#include "Ntp.h"
#include "OpenWeather.h"
#include "Renderer.h"
#include "Settings.h"
#include "Syslog.h"
#include "Timezone.h"
#include "Timezones.h"
#include "WiFiManager.h"
#include "Audio.h"
#include "Animation.h"
#include "html_content.h"

#ifdef SunRiseLib
#include <SunRise.h>
#endif

//******************************************************************************
// Init
//******************************************************************************
// Servers
ESP8266WebServer webServer(80);

ESP8266HTTPUpdateServer httpUpdater;

//Audio Sound
#ifdef AUDIO_SOUND
//SoftwareSerial SoftSer(PIN_AUDIO_TX, PIN_AUDIO_RX, false, 128);
SoftwareSerial SoftSer(PIN_AUDIO_TX, PIN_AUDIO_RX, false);

DFRobotDFPlayerMini Mp3Player;
int16_t SOUNDBASENR[17] = {AUDIO_BASENR0, AUDIO_BASENR1, AUDIO_BASENR2, AUDIO_BASENR3, AUDIO_BASENR4, AUDIO_BASENR5,
                           AUDIO_BASENR6, AUDIO_BASENR7, AUDIO_BASENR8, AUDIO_BASENR9, AUDIO_BASENR10, AUDIO_BASENR11,
                           AUDIO_BASENR12, AUDIO_BASENR_VICKI, AUDIO_BASENR_HANS, AUDIO_BASENR_VICKI_HANS, AUDIO_BASENR_RANDOM
                          };

Ticker BusyPinCheck;

int AUDIO_HOUR = -1;
bool AUDIO_TEST = false;
int16_t volume_test_bck = 10;
bool vickihans24h_bck = false;
bool singlegong_bck = false;
bool vicki_hans_switch = false;
uint8_t testsoundfile = 0;
uint16_t soundbase = 0;
int AUDIO_FILENR = 0;
int ANSAGEBASE = AUDIO_BASENR_VICKI; //vicki
uint8_t VOLUME_ALT = 0;
uint8_t myIPidx = 0;
uint8_t PABStatus = 1;
#endif
int hny = 0;

//BME280 (Temp Sensor)
#ifdef SENSOR_BME280
Adafruit_BME280 bme;
bool bme_status;
float luftdruck_hist[15] = {};
float lufdruck_hour[3] = {};
struct  temperatur_hist_struct
{
  String stundeminute;
  float innentemp;
  float aussentemp;
};
temperatur_hist_struct temperatur_hist[74];
#endif

// IR receiver
#ifdef IR_RECEIVER
IRrecv irrecv(PIN_IR_RECEIVER);
decode_results irDecodeResult;
#endif

// Syslog
#ifdef SYSLOGSERVER_SERVER
WiFiUDP wifiUdp;
Syslog syslog(wifiUdp, SYSLOGSERVER_SERVER, SYSLOGSERVER_PORT, HOSTNAME, "WORTUHR", LOG_INFO);
#endif

// RTC
#ifdef RTC_BACKUP
DS3232RTC RTC;
#endif

// LED driver
//LedDriver_NeoPixel ledDriver;
#ifdef LED_LIBRARY_NEOPIXEL
LedDriver ledDriver;
#endif
// LPD8806RGBW ledDriver
#ifdef LED_LIBRARY_LPD8806RGBW
LedDriver_LPD8806RGBW ledDriver;
#endif

// Renderer
Renderer renderer;

// Settings
Settings settings;
uint8_t akt_transition = 1;
uint8_t akt_transition_old = 1;

// NTP
Ntp ntp;
char ntpServer[50] {};
uint8_t errorCounterNTP = 0;
bool aktntptime = false;

// Screenbuffer
uint16_t matrix[10] = {};
uint16_t matrixOld[10] = {};
boolean screenBufferNeedsUpdate = true;
bool wortuhrinit = true;

// Mode
Mode mode = MODE_TIME;
Mode lastMode = mode;
unsigned long modeTimeout = 0;
uint32_t autoModeChangeTimer = settings.mySettings.auto_mode_change * 60;
boolean runTransitionOnce = false;
uint8_t autoMode = 0;
boolean mode_ohne_sound = false;
boolean single_mode = false;
bool MODE_BUTTON_BOOL = false;
bool SHOW_TIME_BUTTON_BOOL = false;
unsigned long show_off_on_time = 0;
int ModeSequenz = 0;
int modeExtraTime = 0;
int Modecount = 0;


// Time
uint8_t lastDay = 0;
uint8_t lastHour = 0;
uint8_t lastMinute = 0;
uint8_t lastSecond = 0;

uint8_t aktDay = 0;
uint8_t aktHour = 0;
uint8_t aktMinute = 0;
uint8_t aktSecond = 0;

int esptimedrift = 0;
int maxesptimedrift = 0;

uint32_t last500Millis = 0;
uint32_t last50Millis = 0;
time_t upTime = 0;
time_t startTime = 0;
uint8_t randomHour = 0;
uint8_t randomMinute = 0;
uint8_t randomSecond = 0;
int moonphase = 0;
int ani_moonphase = 0;
uint8_t web_moonphase = 0;


#ifdef SunRiseLib
time_t sunRiseTime;
time_t sunSetTime;
SunRise sr;
#endif


// Feed
String feedText = "";
uint8_t feedColor = WHITE;
uint8_t feedPosition = 0;
bool audio_stop_nach_feed = true;

// OpenWeather
#ifdef APIKEY
OpenWeather outdoorWeather;
int errorCounterOutdoorWeather = 0;
uint16_t retcodeOutdoorWeather = 0;
time_t LastOutdoorWeatherTime = 0;
uint16_t WetterSequenz = 0;
uint8_t WetterAnsageSchritt = 0;

#endif

// BME280
float roomTemperature = 0;
float roomHumidity = 0;
float Pressure = 0;
float Pressure_red = 0;
float info_luftdruckdiff = 0;
int luftdrucktendenz_soundbase;
int luftdrucktendenz_web = 0;
uint8_t errorCounterBME = 0;
uint8_t Tempcolor;

// Brightness and LDR
uint8_t brightness = map(settings.mySettings.brightness, 10, 100, MIN_BRIGHTNESS, MAX_BRIGHTNESS);
uint8_t abcBrightness = brightness;
uint16_t ldrValue = 0;
#ifdef LDR
uint16_t lastLdrValue = 0;
uint16_t minLdrValue = MIN_LDR_STARTVALUE; // The ESP will crash if minLdrValue and maxLdrValue are equal due to an error in map()
uint16_t maxLdrValue = MAX_LDR_STARTVALUE;
#endif
bool ldr_update = false;

//Animationen
s_myanimation myanimation;
s_frame copyframe;
uint32_t anipalette[] = { 0xFF0000, 0xFFAA00, 0xFFFF00, 0x00FF00, 0x00FFFF, 0x0000FF, 0xAA00FF, 0xFF00FF, 0x000000, 0xFFFFFF };
String myanimationslist[MAXANIMATION + 1];
uint8_t akt_aniframe = 0;
uint8_t akt_aniloop = 0;
uint8_t frame_fak = 1;        // Animationsrichtung
String animation;
bool playanimation = false;


// Alarm
#if defined(BUZZER) || defined(AUDIO_SOUND)
boolean alarmTimerSet = false;
uint8_t alarmTimer = 0;
uint8_t alarmTimerSecond = 0;
uint8_t alarmOn = false;
#endif

// Events
#ifdef EVENT_TIME
uint32_t showEventTimer = EVENT_TIME;
s_event events[MAXEVENTS + 1];
#endif
bool post_event_ani = false;

//Sunrise
uint8_t sunriseHour = 0;
uint8_t sunriseMinute = 0;
uint8_t sunriseSecond = 0;
boolean ani_sunrise_done = false;

uint8_t sunsetHour = 0;
uint8_t sunsetMinute = 0;
uint8_t sunsetSecond = 0;
boolean ani_sunset_done = false;

// Misc
uint8_t testColumn = 0;
int updateInfo = 0;
IPAddress myIP = { 0, 0, 0, 0 };
unsigned long lastButtonPress = 0;
boolean transitionInProgress = false;
uint8_t colorsaver = 0;
uint8_t colorold = 0;
uint8_t cornercolorold = 0;
String WEB_Uhrtext = "Es ist ...";

uint16_t minFreeBlockSize = 10000;
uint16_t codeline = 0;
String codetab;

boolean mp3reset = false;
uint8_t mp3resetcount = 0;

int WLAN_reconnect = 0;
boolean b_showip = false;

//******************************************************************************
// Setup()
//******************************************************************************

void setup()
{
  // init serial port
  Serial.begin(SERIAL_SPEED);
  while (!Serial);
  delay(2000);
  setTime(12, 0, 0, 1, 2, 2003);

  Serial.println();
  Serial.println(F("****** ") + String(settings.mySettings.systemname) + F(" ******"));
  Serial.println(F("Firmware: ") + String(FIRMWARE_VERSION));
#ifdef DEBUG
  Serial.printf("Size of Settings: %i byte\n", sizeof(settings));
  Serial.printf("ESP BoardVersion: %s\n", ESP.getCoreVersion().c_str());
#endif
  delay(1000);
#ifdef POWERON_SELFTEST
  renderer.setAllScreenBuffer(matrix);
  cornercolorold = settings.mySettings.corner_color;
  Serial.println(F("Set all LEDs to red."));
  settings.mySettings.corner_color = RED;
  writeScreenBuffer(matrix, RED, TEST_BRIGHTNESS);
  delay(2500);
  Serial.println(F("Set all LEDs to green."));
  settings.mySettings.corner_color = GREEN;
  writeScreenBuffer(matrix, GREEN, TEST_BRIGHTNESS);
  delay(2500);
  Serial.println(F("Set all LEDs to blue."));
  settings.mySettings.corner_color = BLUE;
  writeScreenBuffer(matrix, BLUE, TEST_BRIGHTNESS);
  delay(2500);
  Serial.println(F("Set all LEDs to white."));
  settings.mySettings.corner_color = WHITE;
  writeScreenBuffer(matrix, WHITE, TEST_BRIGHTNESS);
  delay(2500);
  settings.mySettings.corner_color = cornercolorold;
#endif

#ifdef ESP_LED
  Serial.println(F("Setting up ESP-LED."));
  pinMode(PIN_LED, OUTPUT);
  digitalWrite(PIN_LED, HIGH);
#endif

#ifdef MODE_BUTTON
  Serial.println(F("Setting up Mode-Button."));
  pinMode(PIN_MODE_BUTTON, INPUT);
  attachInterrupt(digitalPinToInterrupt(PIN_MODE_BUTTON), buttonModeInterrupt, RISING);
#endif

#ifdef ONOFF_BUTTON
  Serial.println(F("Setting up Back-Button."));
  pinMode(PIN_ONOFF_BUTTON, INPUT_PULLUP);
  attachInterrupt(digitalPinToInterrupt(PIN_ONOFF_BUTTON), buttonOnOffInterrupt, FALLING);
#endif

#ifdef SHOW_TIME_BUTTON
  Serial.println(F("Setting up Time-Button."));
  pinMode(PIN_SHOW_TIME_BUTTON, INPUT_PULLUP);
  attachInterrupt(digitalPinToInterrupt(PIN_SHOW_TIME_BUTTON), buttonShowTimeInterrupt, FALLING);
#endif


#ifdef SENSOR_BME280
  Serial.println(F("Setting up BME280."));
  bme_status = bme.begin();
  if (!bme_status) {
    bme_status = bme.begin(0x76);
    if (!bme_status) {
      Serial.println(F("Could not find a valid BME280 sensor, check wiring, address, sensor ID!"));
      Serial.print(F("SensorID was: 0x")); Serial.println(bme.sensorID(), 16);
      Serial.print(F("   ID of 0xFF probably means a bad address, a BMP 180 or BMP 085\n"));
      Serial.print(F("   ID of 0x56-0x58 represents a BMP 280,\n"));
      Serial.print(F("        ID of 0x60 represents a BME 280.\n"));
      Serial.print(F("        ID of 0x61 represents a BME 680.\n"));
    }
  }
#endif

#ifdef BUZZER
  Serial.println(F("Setting up Buzzer."));
  pinMode(PIN_BUZZER, OUTPUT);
#endif

  colorsaver = settings.mySettings.color;
  if ( settings.mySettings.corner_colorChange == COLORCHANGE_MAIN) settings.mySettings.corner_color = settings.mySettings.color;

#ifdef LDR
  Serial.print(F("Setting up LDR. ABC: "));
  settings.mySettings.useAbc ? Serial.println(F("enabled")) : Serial.println(F("disabled"));
  pinMode(PIN_LDR, INPUT);
  if (settings.mySettings.useAbc) setBrightnessFromLdr();
#endif


#ifdef AUDIO_SOUND
  Serial.print(F("Setting up Audio Sound."));
  pinMode(PIN_AUDIO_BUSY, INPUT);
  SoftSer.begin(9600);  // Einstellen der Baudrate auf 9600
  //  SoftSer.begin(9600,SWSERIAL_8N1,PIN_AUDIO_TX, PIN_AUDIO_RX,false, 128);
  delay(500);
  Mp3Player.begin(SoftSer); // Starten der seriellen Kommunikation zwischen dem D1 Mini und dem MP3 Modul.
  Serial.print(F("."));
  delay(750);
  Serial.print(F("."));
  delay(750);
  Serial.print(F("."));
  delay(750);
  Serial.print(F("."));
  delay(750);
  Serial.println(F(". fertig!"));
  
#ifdef LDR
  if (settings.mySettings.useAbc) setBrightnessFromLdr();
#endif

  if ( settings.mySettings.sprecher )
  {
    ANSAGEBASE = AUDIO_BASENR_VICKI; //vicki
  }
  else
  {
    ANSAGEBASE = AUDIO_BASENR_HANS; //hans
  }
  Serial.print(F("Ansagebase ="));
  Serial.println(ANSAGEBASE);
  Mp3Player.volume(1);
  delay(200);
  Mp3Player.EQ(AUDIO_EQUALIZER);
  delay(200);
  Play_MP3(703, false, STARTUPSOUNDLEVEL); //Spiele mp3 Startup
#endif

  delay (500);
  renderer.clearScreenBuffer(matrix);
  renderer.setSmallText("WI", TEXT_POS_TOP, matrix);
  renderer.setSmallText("FI", TEXT_POS_BOTTOM, matrix);
  farbenmeer(matrixOld, matrix, WHITE, brightness);
  wortuhrinit = false;
  setupFS();
  // Load Events
  if ( loadEvents()) Serial.println(F("Events erfolgreich geladen!"));
  else Serial.println(F("Events konnten nicht geladen werden!"));
  // Load Animationsliste
  getAnimationList();

#ifdef IR_RECEIVER
  Serial.println(F("Setting up IR-Receiver."));
  irrecv.enableIRIn();
#endif

  // Start WiFi and services
  writeScreenBuffer(matrix, WHITE, brightness);
  WiFi.hostname(String(settings.mySettings.systemname));    //
  WiFiManager wifiManager;
  //wifiManager.resetSettings();
  wifiManager.setTimeout(WIFI_SETUP_TIMEOUT);
  wifiManager.autoConnect(settings.mySettings.systemname, WIFI_AP_PASS);
  WiFi.setAutoReconnect(true);
  if (!WiFi.isConnected())
  {
    //		WiFi.mode(WIFI_AP);
    Serial.println(F("No WLAN connected. Staying in AP mode."));
    writeScreenBuffer(matrix, RED, brightness);
#if defined(BUZZER) && defined(WIFI_BEEPS)
    digitalWrite(PIN_BUZZER, HIGH);
    delay(1500);
    digitalWrite(PIN_BUZZER, LOW);
#endif
#if defined(AUDIO_SOUND) && defined(WIFI_BEEPS)
    Play_MP3(ANSAGEBASE + 51, false, STARTUPSOUNDLEVEL); //Wlan nicht OK
#endif
    WiFi.mode(WIFI_AP);
    delay(3000);
    myIP = WiFi.softAPIP();
  }
  else
  {
    WiFi.mode(WIFI_STA);
    Serial.println(F("WLAN connected. Switching to STA mode."));
    Serial.print(F("Aktuelle IP ist : "));
    Serial.println(WiFi.localIP());
    writeScreenBuffer(matrix, GREEN, brightness);
#if defined(BUZZER) && defined(WIFI_BEEPS)
    for (uint8_t i = 0; i <= 2; i++)
    {
#ifdef DEBUG
      Serial.println(F("Beep!"));
#endif
      digitalWrite(PIN_BUZZER, HIGH);
      delay(100);
      digitalWrite(PIN_BUZZER, LOW);
      delay(100);
    }
#endif
#if defined(AUDIO_SOUND) && defined(WIFI_BEEPS)
    Serial.println(F("sprich: WLAN-verbunden."));
    Play_MP3(ANSAGEBASE + 50, true, STARTUPSOUNDLEVEL);
#endif
    delay(500);
    // Highscores aus EPROM holen
    highscore[SNAKE] = settings.mySettings.highscore[SNAKE];
    highscore[TETRIS] = settings.mySettings.highscore[TETRIS];
    highscore[BRICKS] = settings.mySettings.highscore[BRICKS];
    highscore[VIERGEWINNT] = settings.mySettings.highscore[VIERGEWINNT];
    delay(500);

    myIP = WiFi.localIP();

    // mDNS is needed to see HOSTNAME in Arduino IDE
    Serial.println(F("Starting mDNS responder."));
    MDNS.begin(String(settings.mySettings.systemname));
    //MDNS.addService("http", "tcp", 80);

    Serial.println(F("Starting OTA service."));
#ifdef DEBUG
    ArduinoOTA.onStart([]()
    {
      Serial.println(F("Start OTA update."));
    });
    ArduinoOTA.onError([](ota_error_t error)
    {
      Serial.println(F("OTA Error: ") + String(error));
      if (error == OTA_AUTH_ERROR) Serial.println(F("Auth failed."));
      else if (error == OTA_BEGIN_ERROR) Serial.println(F("Begin failed."));
      else if (error == OTA_CONNECT_ERROR) Serial.println(F("Connect failed."));
      else if (error == OTA_RECEIVE_ERROR) Serial.println(F("Receive failed."));
      else if (error == OTA_END_ERROR) Serial.println(F("End failed."));
    });
    ArduinoOTA.onEnd([]()
    {
      Serial.println(F("End OTA update."));
    });
#endif
    ArduinoOTA.setHostname(settings.mySettings.systemname);
#ifdef OTA_PASS
    ArduinoOTA.setPassword(OTA_PASS);
#endif
    ArduinoOTA.begin();

#ifdef SYSLOGSERVER_SERVER
    Serial.println(F("Starting syslog."));
#ifdef APIKEY
    syslog.log(LOG_INFO, ";#;dateTime;roomTemperature;roomHumidity;outdoorTemperature;outdoorHumidity;ldrValue;errorCounterNTP;errorCounterBME;errorCounterOutdoorWeather;freeHeapSize;upTime");
#else
    syslog.log(LOG_INFO, ";#;dateTime;roomTemperature;roomHumidity;ldrValue;errorCounterNTP;errorCounterBME;freeHeapSize;upTime");
#endif
#endif
    if ( b_showip )
    {
       mode = MODE_IP;
    }
  }

#ifdef SHOW_IP
  if ( !b_showip )
  {
    WiFi.isConnected() ? feedText = F("  IP: ") : feedText = F("  AP-IP: ");
    feedText += String(myIP[0]) + '.' + String(myIP[1]) + '.' + String(myIP[2]) + '.' + String(myIP[3]) + "   ";
    Serial.print(F("Show-IP Text:"));
    Serial.println(feedText);
    feedPosition = 0;
    feedColor = WHITE;
    mode = MODE_FEED;
  }
#endif

  Serial.println(F("Starting webserver."));
  setupWebServer();
  delay (500);
  Serial.println(F("Starting updateserver."));
  httpUpdater.setup(&webServer);

  renderer.clearScreenBuffer(matrix);

#ifdef RTC_BACKUP
  RTC.begin();
  setSyncProvider(RTC.get);
  Serial.print(F("RTC Sync."));
  if (timeStatus() != timeSet) Serial.print(F(" FAIL!"));
  Serial.println();
#ifdef DEBUG
  time_t tempRtcTime = RTC.get();
  Serial.printf("Time (RTC): %02u:%02u:%02u %02u.%02u.%04u\r\n", hour(tempRtcTime), minute(tempRtcTime), second(tempRtcTime), day(tempRtcTime), month(tempRtcTime), year(tempRtcTime));
#endif
#endif

  // Get the time!
  if (WiFi.isConnected())
  {
    // Set ESP (and RTC) time from NTP
    strcpy(ntpServer, settings.mySettings.ntphost);
    time_t tempNtpTime = ntp.getTime(ntpServer);
    if (tempNtpTime)
    {
      errorCounterNTP = 0;
      startTime = tempNtpTime;
      setTime(timeZone.toLocal(tempNtpTime));
#ifdef DEBUG
      Serial.printf("Time (NTP): %02u:%02u:%02u %02u.%02u.%04u (UTC)\r\n", hour(tempNtpTime), minute(tempNtpTime), second(tempNtpTime), day(tempNtpTime), month(tempNtpTime), year(tempNtpTime));
      Serial.printf("Drift (ESP): %d sec.\r\n", tempNtpTime - timeZone.toUTC(now()));
#endif
#ifdef RTC_BACKUP
      RTC.set(timeZone.toLocal(tempNtpTime));
#ifdef DEBUG
      Serial.printf("Drift (RTC): %d sec.\r\n", tempNtpTime - timeZone.toUTC(RTC.get()));
#endif
#endif
      if ( ausperiode() && !b_showip )
      {
#ifdef DEBUG
        Serial.println(F("AusPeriode -> ModeBlank"));
#endif
        setMode(MODE_BLANK);
      }
    }
    else
    {
      startTime = timeZone.toUTC(now());  // setze Startzeit auf dummy Zeit 1.2.2003 12:00 (UTC)
      if (errorCounterNTP < 255) errorCounterNTP++;
#ifdef DEBUG
      Serial.printf("Error (NTP): %u\r\n", errorCounterNTP);
#endif
    }
#ifdef DEBUG
    Serial.printf("StartTime: %02u:%02u:%02u %02u.%02u.%04u\r\n", hour(startTime), minute(startTime), second(startTime), day(startTime), month(startTime), year(startTime));
#endif
  }

  // Define a random time
  randomSeed(analogRead(A0));
  randomHour = random(9, 16);
  for (uint8_t i = 0; i <= 20; i++)
  {
    randomMinute = random(23, 37);           // eine Zufallsminute die nicht auf eine volle 5 Minute fällt
    if ( randomMinute % 5 != 0 ) break;
  }
  randomSecond = random(5, 56);

  if (WiFi.isConnected())
  {
    // Get weather from OpenWeather
#ifdef APIKEY
#ifdef DEBUG_OW
    Serial.println(F("Getting outdoor weather (INIT):"));
#endif
    delay(500);
    retcodeOutdoorWeather = outdoorWeather.getOutdoorConditions(String(settings.mySettings.openweatherlocation), String(settings.mySettings.openweatherapikey));
    if ( retcodeOutdoorWeather > 0 )
    {
#ifdef DEBUG_OW
      Serial.println(F("OpenWeather Error"));
#endif
      errorCounterOutdoorWeather++;
      LastOutdoorWeatherTime = 0;
    }
    else
    {
      LastOutdoorWeatherTime = startTime;
    }
#ifdef DEBUG_OW
    Serial.println(outdoorWeather.description);
    Serial.println(outdoorWeather.temperature);
    Serial.println(outdoorWeather.humidity);
    Serial.println(outdoorWeather.pressure);
#endif
    sunriseset();
#endif
  }

  // Update room conditions
#ifdef SENSOR_BME280
  getRoomConditions();
  // Initialisierung der Luftdruck Werte mit dummy Werte
  for (uint8_t ze = 0; ze <= 10; ze++)
  {
    if ( Pressure_red < LUFTDRUCKMIN ) Pressure_red = LUFTDRUCKMIN + 30;
    luftdruck_hist[ze] = Pressure_red + float(0.17 * (ze * ze) - 0.95 * ze - 2.5);
  }
  luftdruck_hist[0] = Pressure_red;
  luftdruck_hist[8] = Pressure_red;
  luftdruck_hist[9] = Pressure_red;
  luftdruck_hist[10] = Pressure_red;
  lufdruck_hour[0] = Pressure_red;
  lufdruck_hour[1] = Pressure_red;
  lufdruck_hour[2] = Pressure_red;

  // Initialisierung der Temperatur Werte mit dummy Werte
  int stunde = hour();
  int temp_init_z = 0;
  for (int s = 0 ; s < 24; s++)
  {
    if ( stunde > 23) stunde = 0;
    for (int m = 0 ; m < 60; m = m + 20)
    {
      temperatur_hist[temp_init_z].stundeminute = String(stunde);
      if ( stunde < 10 ) temperatur_hist[temp_init_z].stundeminute = "0" + temperatur_hist[temp_init_z].stundeminute;
      String c_minuten = String(m);
      if ( m < 10 ) c_minuten = "0" + c_minuten;
      temperatur_hist[temp_init_z].stundeminute = temperatur_hist[temp_init_z].stundeminute + ":" + c_minuten;
      temperatur_hist[temp_init_z].innentemp = roomTemperature + random(1, 4) - 1.5;
      temperatur_hist[temp_init_z].aussentemp = 0;
#ifdef APIKEY
      temperatur_hist[temp_init_z].aussentemp = stunde * 2.5 - 15;
#endif
      temp_init_z++;
    }
    stunde++;
  }
  temperatur_hist[72].stundeminute = "SS:MM";
  temperatur_hist[72].innentemp = roomTemperature;
  temperatur_hist[72].aussentemp = 0;
  temperatur_hist[73].stundeminute = "SS:MM";
  temperatur_hist[73].innentemp = roomTemperature;
  temperatur_hist[73].aussentemp = 0;
#ifdef APIKEY
  temperatur_hist[72].aussentemp = outdoorWeather.temperature;
  temperatur_hist[73].aussentemp = outdoorWeather.temperature;
#endif

#endif

  // print some infos
#ifdef DEBUG
  Serial.printf("Day on: %02u:%02u:00\r\n", hour(settings.mySettings.dayOnTime), minute(settings.mySettings.dayOnTime));
  Serial.printf("Night off: %02u:%02u:00\r\n", hour(settings.mySettings.nightOffTime), minute(settings.mySettings.nightOffTime));
  Serial.printf("Alarm1: %02u:%02u:00 ", hour(settings.mySettings.alarm1Time), minute(settings.mySettings.alarm1Time));
  settings.mySettings.alarm1 ? Serial.print("on ") : Serial.print("off ");
  Serial.println(settings.mySettings.alarm1Weekdays, BIN);
  Serial.printf("Alarm2: %02u:%02u:00 ", hour(settings.mySettings.alarm2Time), minute(settings.mySettings.alarm2Time));
  settings.mySettings.alarm2 ? Serial.print("on ") : Serial.print("off ");
  Serial.println(settings.mySettings.alarm2Weekdays, BIN);
  Serial.printf("Random time: %02u:%02u:%02u\r\n", randomHour, randomMinute, randomSecond);
  Serial.println(F("DEBUG is on."));
#else
  Serial.println(F("DEBUG is off."));
#endif

  lastDay = day() - 1;
  lastHour = hour();
  lastMinute = minute();
  lastSecond = second();

#ifdef FRONTCOVER_BINARY
  settings.setTransition(TRANSITION_NORMAL);
#endif
} // setup()

// ******************************************************************************##################################################################
// Loop()
// ******************************************************************************##################################################################

void loop()
{
  ESP.wdtFeed(); //Setzt den Timer beider Watchdogs (Hardware+Software) zurück
  aktDay = day();
  aktHour = hour();
  aktMinute = minute();
  aktSecond = second();

  // ************************************************************************
  // Run once a day
  // ************************************************************************
  if (aktDay != lastDay)
  {
    lastDay = aktDay;
    screenBufferNeedsUpdate = true;

#ifdef SHOW_MODE_MOONPHASE
    moonphase = getMoonphase(year(), month(), day());
#endif

    // SunRise
#ifdef SunRiseLib
    sr.calculate(settings.mySettings.latitude, settings.mySettings.longitude, timeZone.toUTC(now()) );
    sunRiseTime = timeZone.toLocal(sr.riseTime);
    sunSetTime = timeZone.toLocal(sr.setTime);
    sunriseset();
#ifdef DEBUG
    Serial.printf("Sunrise: %02u:%02u:%02u %02u.%02u.%04u\r\n", sunriseHour , sunriseMinute, sunriseSecond, day(sunRiseTime), month(sunRiseTime), year(sunRiseTime));
    Serial.printf("Sunset : %02u:%02u:%02u %02u.%02u.%04u\r\n", sunsetHour, sunsetMinute, sunsetSecond, day(sunSetTime), month(sunSetTime), year(sunSetTime));
#endif
#endif

    ani_sunrise_done = false;
    ani_sunset_done = false;

    // Reset URL event 0
    events[0].aktiv = false;
    events[0].year = 0;
    events[0].month = 0;
    events[0].day = 0;
    events[0].text = "";
    events[0].color = 0;
    events[0].audio_file = 0;
    events[0].preani = "";
    events[0].postani = "";
    events[0].intervall = 0;
    showEventTimer = 20;

#ifdef DEBUG
    Serial.printf("Date: %02u.%02u.%02u  %02u:%02u:%02u\r\n", aktDay, month(), year(), aktHour, aktMinute, aktSecond);
    Serial.printf("Uptime: %u days, %02u:%02u\r\n", int(upTime / 86400), hour(upTime), minute(upTime));
    Serial.printf("Free RAM: %u bytes\r\n", system_get_free_heap_size());
    Serial.printf("Moonphase: %u\r\n", moonphase);
#endif

    // Change color
    if (settings.mySettings.colorChange == COLORCHANGE_DAY)
    {
      changecolor();
#ifdef DEBUG
      Serial.printf("Color changed to: %u\r\n", settings.mySettings.color);
#endif
    }
    // Change cornercolor
    if (settings.mySettings.corner_colorChange == COLORCHANGE_DAY)
    {
      changecornercolor();

#ifdef DEBUG
      Serial.printf("Corner Color changed to: %u\r\n", settings.mySettings.corner_color);
#endif
    }

    Modecount = 0;
    for ( uint8_t gc = 0; gc < 9; gc++) gamecount[gc] = 0; // löschen der Spiele pro Tag
#ifdef APIKEY
    errorCounterOutdoorWeather = 0;
#endif
    mp3resetcount = 0;
    WLAN_reconnect = 0;
    maxesptimedrift = 0;
    minFreeBlockSize = ESP.getMaxFreeBlockSize();
    codeline = __LINE__;
    codetab = __NAME__;
#ifdef DEBUG
    Serial.printf("minFreeBlockSize: %i Tab: %s Codezeile: %u\n", minFreeBlockSize, codetab.c_str(), codeline);
#endif
  }

  // ************************************************************************
  // Run once every hour
  // ************************************************************************

  if (aktHour != lastHour)
  {
    lastHour = aktHour;
    screenBufferNeedsUpdate = true;

    // Change color
    if (settings.mySettings.colorChange == COLORCHANGE_HOUR)
    {
      changecolor();

#ifdef DEBUG
      Serial.printf("Color changed to: %u\r\n", settings.mySettings.color);
#endif
    }
    // Change cornercolor
    if (settings.mySettings.corner_colorChange == COLORCHANGE_HOUR)
    {
      changecornercolor();

#ifdef DEBUG
      Serial.printf("Corner Color changed to: %u\r\n", settings.mySettings.corner_color);
#endif
    }


    // Hourly beep
#ifdef BUZZER
    if ((settings.mySettings.hourBeep == true) && (mode == MODE_TIME) && minute() < 2 )
    {
      digitalWrite(PIN_BUZZER, HIGH);
      delay(25);
      digitalWrite(PIN_BUZZER, LOW);
#ifdef DEBUG
      Serial.println(F("Beep!"));
#endif
    }
#endif

#ifdef AUDIO_SOUND
    if ((settings.mySettings.hourBeep == true) && (mode == MODE_TIME) && minute() < 2 )
    {
      AUDIO_HOUR = aktHour;
#ifdef DEBUG
      Serial.println(F("Set AUDIO_HOUR"));
#endif
    }
#endif


    // ************************************************************************
    // Run once every random hour (once a day)
    // ************************************************************************

  }

  // ************************************************************************
  // Run once every minute
  // ************************************************************************

  if (aktMinute != lastMinute)
  {
    // Check ob wir nach einem Neustart ab 5 Minuten die aktuelle Zeit haben. Wenn nicht dann Neustart.
    if ( millis() / 1000 > 300 && millis() / 1000 < 600 && year() < 2010 )
    {
      // Wenn WLAN Verbunden und die IP-Adresse wird angezeigt erfolgt kein Neustart.
      if ( !( WiFi.isConnected() && b_showip ) )
      {
        Serial.println(F("Nach 5 Minuten konnte keine aktuelle Zeit geholt werden! "));
        Serial.println(F("Wir versuchen einen Neustart.... "));
        ESP.restart();
      }
    }

    lastMinute = aktMinute;
    screenBufferNeedsUpdate = true;
    myIP = WiFi.localIP();
    if (WiFi.status() != WL_CONNECTED || ( myIP[0] == 0 && myIP[1] == 0 && myIP[2] == 0 && myIP[3] == 0))
    {
#ifdef DEBUG
      Serial.print(F("Aktuelle IP ist : "));
      Serial.println(WiFi.localIP());
      Serial.println (F("WLAN-Reconnect!"));
#endif
      WiFi.reconnect();
      WLAN_reconnect++;
      delay(100);
#ifdef DEBUG
      Serial.print(F("Aktuelle IP nach Reconnect ist : "));
      Serial.println(WiFi.localIP());
#endif
    }
#if defined(RTC_BACKUP) || defined(SENSOR_BME280)
    // Update room conditions
    getRoomConditions();
#endif

#if defined(BUZZER) || defined(AUDIO_SOUND)
    // Switch on buzzer for alarm 1
    if (settings.mySettings.alarm1 && (aktHour == hour(settings.mySettings.alarm1Time)) && (aktMinute == minute(settings.mySettings.alarm1Time)) && bitRead(settings.mySettings.alarm1Weekdays, weekday()))
    {
      alarmOn = BUZZTIME_ALARM_1 * 4;
#ifdef DEBUG
      Serial.println(F("Alarm1 on."));
#endif
    }

    // Switch on buzzer for alarm 2
    if (settings.mySettings.alarm2 && (aktHour == hour(settings.mySettings.alarm2Time)) && (aktMinute == minute(settings.mySettings.alarm2Time)) && bitRead(settings.mySettings.alarm2Weekdays, weekday()))
    {
      alarmOn = BUZZTIME_ALARM_2 * 4;
#ifdef DEBUG
      Serial.println(F("Alarm2 on."));
#endif
    }
#endif

#ifdef DEBUG
    time_t tempEspTime = now();
    Serial.printf("Time (ESP): %02u:%02u:%02u %02u.%02u.%04u\r\n", hour(tempEspTime), minute(tempEspTime), second(tempEspTime), day(tempEspTime), month(tempEspTime), year(tempEspTime));
#ifdef RTC_BACKUP
    time_t tempRtcTime = RTC.get();
    Serial.printf("Time (RTC): %02u:%02u:%02u %02u.%02u.%04u\r\n", hour(tempRtcTime), minute(tempRtcTime), second(tempRtcTime), day(tempRtcTime), month(tempRtcTime), year(tempRtcTime));
#endif
#endif

    // Set night- and daymode
    if ( (aktHour == hour(settings.mySettings.nightOffTime)) && (aktMinute == minute(settings.mySettings.nightOffTime)) )
    {
#ifdef DEBUG
      Serial.println(F("Nachts aus"));
#endif
      setMode(MODE_BLANK);
    }
    if ((aktHour == hour(settings.mySettings.dayOnTime)) && (aktMinute == minute(settings.mySettings.dayOnTime)))
    {
#ifdef DEBUG
      Serial.println(F("Tags ein."));
#endif
      setMode(lastMode);
    }

    //*************************************************************************
    // Prüfen ob es zur aktuellen Minute eine Animation gibt
    //*************************************************************************
    if ( mode == MODE_TIME )
    {
      animation = "Z";
      if ( aktHour <= 9 ) animation += "0";
      animation += String(aktHour);
      if ( aktMinute <= 9 ) animation += "0";
      animation += String(aktMinute);
      //    Serial.println ( animation);
      playanimation = false;
      if ( not ( month() == 1 && day() == 1 && hour() == 0 && minute() <= 9 ))  // An Neujahr die ersten 9 Minuten keine Animation zulassen!
      {
        for ( int aninr = 0; aninr <= MAXANIMATION; aninr++ )
        {
          if ( myanimationslist[aninr].length() == 0 || myanimationslist[aninr] == "neu" ) continue;
          if ( myanimationslist[aninr] == animation)
          {
            playanimation = true;
            break;
          }
        }
      }
    }

    // ************************************************************************
    // Run once every random minute (once an hour) or if NTP has an error
    // ************************************************************************

    if ((aktMinute == randomMinute) || aktntptime || ((errorCounterNTP > 0) && (errorCounterNTP < 30)))
    {
      aktntptime = false;
      if (WiFi.isConnected())
      {
        // Set ESP (and RTC) time from NTP
        time_t tempNtpTime = ntp.getTime(ntpServer);
        if (tempNtpTime && year(tempNtpTime) > 2010)
        {
          errorCounterNTP = 0;
          if ( year(timeZone.toUTC(now())) > 2010) esptimedrift = tempNtpTime - timeZone.toUTC(now());
          if ( abs(esptimedrift) > abs(maxesptimedrift) ) maxesptimedrift = esptimedrift;

#ifdef DEBUG
          Serial.printf("Time (NTP): %02u:%02u:%02u %02u.%02u.%04u (UTC)\r\n", hour(tempNtpTime), minute(tempNtpTime), second(tempNtpTime), day(tempNtpTime), month(tempNtpTime), year(tempNtpTime));
          Serial.printf("Drift (ESP): %d sec.\r\n", esptimedrift);
#endif
          setTime(timeZone.toLocal(tempNtpTime));
#ifdef RTC_BACKUP
          RTC.set(timeZone.toLocal(tempNtpTime));
#ifdef DEBUG
          Serial.printf("Drift (RTC): %d sec.\r\n", tempNtpTime - timeZone.toUTC(RTC.get()));
#endif
#endif
        }
        else
        {
          if (errorCounterNTP < 255) errorCounterNTP++;
#ifdef DEBUG
          Serial.printf("Error (NTP): %u\r\n", errorCounterNTP);
#endif
        }
      }
      else
      {
        if (errorCounterNTP < 255) errorCounterNTP++;
#ifdef DEBUG
        Serial.printf("Error (NTP): %u\r\n", errorCounterNTP);
#endif
      }

    }

    if (aktMinute == randomMinute)
    {
      if (errorCounterNTP > 53) // = 30 Minuten + 24 Stunden
      {
#ifdef AUDIO_SOUND
        AUDIO_FILENR = ANSAGEBASE + 29;  // Zeitserver Meldung
        Play_MP3(AUDIO_FILENR, true, 0);
        delay(3000);
#endif
        settings.mySettings.color = RED;
        colorsaver = settings.mySettings.color;
        settings.mySettings.colorChange = COLORCHANGE_NO;
      }
#ifdef CHECK_MP3
      if ( mode == MODE_TIME )
      {
#ifdef DEBUG_AUDIO
        Serial.println(F("Check MP3 Player:"));
#endif
        mp3reset = false;
        Play_MP3(99, true, 1); //Stop, kein Ton. BusyPin muss kurz an gehen.
        if ( mp3reset )
        {
          do_mp3reset();
          mp3resetcount++;
        }
        else
        {
#ifdef DEBUG_AUDIO
          Serial.println(F("MP3 Player ist OK"));
#endif
        }
      }
#endif
    }

#ifdef APIKEY
    // ************************************************************************
    // Alle 10 minutes +4 neue Wetterdaten holen
    // ************************************************************************
    if ( aktMinute % 10 == 4 && timeZone.toUTC(now()) > LastOutdoorWeatherTime + OPENWEATHER_PERIODE && errorCounterOutdoorWeather < OPENWEATHER_MAX_ERROR )
    {
      if (WiFi.isConnected())
      {
#ifdef DEBUG_OW
        Serial.println(F("Getting outdoor weather:"));
#endif
        // Get weather from OpenWeather
        retcodeOutdoorWeather = outdoorWeather.getOutdoorConditions(String(settings.mySettings.openweatherlocation), String(settings.mySettings.openweatherapikey));
        if ( retcodeOutdoorWeather > 0 )
        {
#ifdef DEBUG_OW
          Serial.println(F("OpenWeather Error"));
#endif
          errorCounterOutdoorWeather++;
        }
        else
        {
          LastOutdoorWeatherTime = timeZone.toUTC(now());
        }
        sunriseset();
#ifdef DEBUG_OW
        Serial.println(F( "Request Outdoor Weather :"));
        Serial.println(outdoorWeather.description);
        Serial.println(outdoorWeather.temperature);
        Serial.println(outdoorWeather.humidity);
        Serial.println(outdoorWeather.pressure);
#endif
      }
    }
#endif


    // SunRise
#ifdef SunRiseLib
    if (aktMinute == randomMinute + 1 )
    {
      sr.calculate(settings.mySettings.latitude, settings.mySettings.longitude, timeZone.toUTC(now()) );
      sunRiseTime = timeZone.toLocal(sr.riseTime);
      sunSetTime = timeZone.toLocal(sr.setTime);
#ifdef DEBUG
      Serial.printf("Sunrise: %02u:%02u:%02u %02u.%02u.%04u\r\n", hour(sunRiseTime), minute(sunRiseTime), second(sunRiseTime), day(sunRiseTime), month(sunRiseTime), year(sunRiseTime));
      Serial.printf("Sunset : %02u:%02u:%02u %02u.%02u.%04u\r\n", hour(sunSetTime), minute(sunSetTime), second(sunSetTime), day(sunSetTime), month(sunSetTime), year(sunSetTime));
#endif
    }
#endif

    // ************************************************************************
    // Run once every 5 minutes
    // ************************************************************************

    if (aktMinute % 5 == 0)
    {

#ifdef SYSLOGSERVER_SERVER
      // Write some data to syslog
      if (WiFi.isConnected())
      {
        time_t tempEspTime = now();
#ifdef APIKEY
        syslog.log(LOG_INFO, ";D;" + String(tempEspTime) + ";" + String(roomTemperature) + ";" + String(roomHumidity) + ";" + String(outdoorWeather.temperature) + ";" + String(outdoorWeather.humidity) + ";" + String(ldrValue)\
                   + ";" + String(errorCounterNTP) + ";" + String(errorCounterBME) + ";" + String(errorCounterOutdoorWeather) + ";" + String(ESP.getFreeHeap()) + ";" + String(upTime));
#else
        syslog.log(LOG_INFO, ";D;" + String(tempEspTime) + ";" + String(roomTemperature) + ";" + String(roomHumidity) + ";" + String(ldrValue)\
                   + ";" + String(errorCounterNTP) + ";" + String(errorCounterBME) + ";" + String(ESP.getFreeHeap()) + ";" + String(upTime));
#endif
#ifdef DEBUG
        Serial.println(F("Data written to syslog."));
#endif
      }
#endif
      // Change color
      if (settings.mySettings.colorChange == COLORCHANGE_FIVE)
      {
        changecolor();

#ifdef DEBUG
        Serial.printf("Color changed to: %u\r\n", settings.mySettings.color);
#endif
      }
      // Change cornercolor
      if (settings.mySettings.corner_colorChange == COLORCHANGE_FIVE)
      {
        changecornercolor();

#ifdef DEBUG
        Serial.printf("Corner Color changed to: %u\r\n", settings.mySettings.corner_color);
#endif
      }
    }
  }

  // ************************************************************************
  // Run once every second
  // ************************************************************************

  if (aktSecond != lastSecond)
  {
    lastSecond = aktSecond;

    if ( year(startTime) > 2010 )         // Startzeit passt
    {
      upTime = timeZone.toUTC(now()) - startTime;
    }
    else
    {
      if ( year(timeZone.toUTC(now())) > 2010 )  // Wenn die aktuelle Zeit passt kann daraus jetzt die Startzeit ermittelt werden
      {
        startTime = timeZone.toUTC(now()) - millis() / 1000;
        upTime = timeZone.toUTC(now()) - startTime;
#ifdef DEBUG
        Serial.printf("Neue StartTime: %02u:%02u:%02u %02u.%02u.%04u\r\n", hour(startTime), minute(startTime), second(startTime), day(startTime), month(startTime), year(startTime));
#endif
      }
      else
      {
        upTime = millis() / 1000;
      }
    }

#ifdef AUDIO_SOUND
    //Silvester Countdown
    if ( mode == MODE_TIME && month() == 12 && aktDay == 31 && aktHour == 23 && aktMinute == 59 && aktSecond == 49 )
    {
      delay (100);
      AUDIO_FILENR = ANSAGEBASE + 170;  //Countdown
      Play_MP3(AUDIO_FILENR, false, 450);
    }
#endif


#ifdef BUZZER
    // Make some noise
    if (alarmOn)
    {
      alarmOn--;
      digitalRead(PIN_BUZZER) == LOW ? digitalWrite(PIN_BUZZER, HIGH) : digitalWrite(PIN_BUZZER, LOW);
      if (!alarmOn)
      {
#ifdef DEBUG
        Serial.println(F("Alarm: off"));
#endif
        digitalWrite(PIN_BUZZER, LOW);
        screenBufferNeedsUpdate = true;
      }
    }
#endif
#ifdef AUDIO_SOUND
    // Make some noise
    if (alarmOn)
    {
      alarmOn--;
      if ( digitalRead(PIN_AUDIO_BUSY) ) Play_MP3(705, false, 200); //Alarm

      if (!alarmOn)
      {
#ifdef DEBUG
        Serial.println(F("Alarm: off"));
#endif
        screenBufferNeedsUpdate = true;
      }
    }
    if (alarmOn && mode != MODE_ALARMANIMATION && year() > 2010 )
    {
      animation = "ALARM";
      for ( int aninr = 0; aninr <= MAXANIMATION; aninr++ )
      {
        if ( myanimationslist[aninr].length() == 0 || myanimationslist[aninr] == "neu" ) continue;
        if ( myanimationslist[aninr] == animation)
        {
          if ( loadAnimation(animation) )
          {
            akt_aniframe = 0;
            akt_aniloop = 0;
            frame_fak = 0;
            mode = MODE_ALARMANIMATION;
          }
          break;
        }
      }
      if ( mode != MODE_ALARMANIMATION ) delay (100);
    }
#endif

    // Set brightness from LDR
#ifdef LDR
    if (settings.mySettings.useAbc) setBrightnessFromLdr();
#endif

#ifdef FRONTCOVER_BINARY
    if (mode != MODE_BLANK) screenBufferNeedsUpdate = true;
#else
    // Running displayupdate in MODE_TIME or MODE_BLANK every second will lock the ESP due to TRANSITION_FADE
    if ((mode != MODE_TIME) && (mode != MODE_BLANK) && (mode != MODE_MAKEANIMATION) ) screenBufferNeedsUpdate = true;
#endif

    // Flash ESP LED
#ifdef ESP_LED
    digitalWrite(PIN_LED, !digitalRead(PIN_LED));
#endif

    // Countdown timeralarm by one minute in the second it was activated
#if defined(BUZZER) || defined(AUDIO_SOUND)
    if (alarmTimer && alarmTimerSet && (alarmTimerSecond == aktSecond))
    {
      alarmTimer--;
#ifdef DEBUG
      if (alarmTimer) Serial.printf("Timeralarm in %u min.\r\n", alarmTimer);
#endif
    }
    // Switch on buzzer for timer
    if (!alarmTimer && alarmTimerSet)
    {
      alarmTimerSet = false;
      alarmOn = BUZZTIME_TIMER * 4;
#ifdef DEBUG
      Serial.println(F("Timeralarm: on"));
#endif
    }
#endif

    // *********************************************************************************
    // ************************** Sunrise/Sunset  **************************************
    // *********************************************************************************
    // SunRise
    if ( mode == MODE_TIME && sunriseHour > 0 )
    {
      if ( settings.mySettings.ani_sunrise && !ani_sunrise_done && sunriseHour == aktHour && sunriseMinute == aktMinute && aktSecond > sunriseSecond )
      {
        ani_sunrise_done = true;
        animation = String(F(ANI_SUNRISE));
        if ( loadAnimation(animation) )
        {
          akt_aniframe = 0;
          akt_aniloop = 0;
          frame_fak = 0;
#ifdef DEBUG
          Serial.println("Starte SunRise Animation: " + animation );
#endif
#ifdef AUDIO_SOUND
          Zeitansage(ANSAGEBASE, 0);
#endif
          while ( showAnimation(brightness) )
          {
#ifdef AUDIO_SOUND
            if ( akt_aniframe == 1 )
            {

              AUDIO_FILENR = ANSAGEBASE + 165;
              Play_MP3(AUDIO_FILENR, false, 0);
            }
#endif
          }
          screenBufferNeedsUpdate = true;
          if (autoModeChangeTimer < 10 ) autoModeChangeTimer + 10;
          if (showEventTimer < 10 ) showEventTimer + 10;
        }
      }
    }
    // SunSet
    if ( mode == MODE_TIME && sunsetHour > 0 )
    {
      if ( settings.mySettings.ani_sunset && !ani_sunset_done && sunsetHour == aktHour && sunsetMinute == aktMinute && aktSecond > sunsetSecond )
      {
        ani_sunset_done = true;
        animation = String(F(ANI_SUNSET));
        if ( loadAnimation(animation) )
        {
          akt_aniframe = 0;
          akt_aniloop = 0;
          frame_fak = 0;
#ifdef DEBUG
          Serial.println("Starte SunSet Animation: " + animation );
#endif
#ifdef AUDIO_SOUND
          Zeitansage(ANSAGEBASE, 0);
#endif
          while ( showAnimation(brightness) )
          {
#ifdef AUDIO_SOUND
            if ( akt_aniframe == 1 )
            {
              AUDIO_FILENR = ANSAGEBASE + 166;
              Play_MP3(AUDIO_FILENR, false, 0);
            }
#endif
          }
          screenBufferNeedsUpdate = true;
          if (autoModeChangeTimer < 10 ) autoModeChangeTimer + 10;
          if (showEventTimer < 10 ) showEventTimer + 10;
        }
      }
    }

    // *********************************************************************************
    // ************************** Auto switch modes  ***********************************
    // *********************************************************************************
    if (settings.mySettings.modeChange && (mode == MODE_TIME))
    {
      autoModeChangeTimer--;
      if (!autoModeChangeTimer)
      {
        if ( aktSecond > 45 )
        {
          autoModeChangeTimer = autoModeChangeTimer + 30;
        }
        else if ( aktSecond < 15 )
        {
          autoModeChangeTimer = autoModeChangeTimer + 15;
        }
        else
        {
#ifdef DEBUG
          Serial.println("Auto modechange. (" + String(autoMode) + ")");
#endif
          autoModeChangeTimer = settings.mySettings.auto_mode_change * 60;
          mode_ohne_sound = true;
          single_mode = true;
          colorsaver = settings.mySettings.color;
          switch (autoMode)
          {
            case 0:
#ifdef APIKEY
              if (WiFi.isConnected() && strlen(settings.mySettings.openweatherapikey) > 25 ) setMode(MODE_EXT_TEMP);
#endif
              autoMode = 1;
              break;

            case 1:
#if defined(RTC_BACKUP) || defined(SENSOR_BME280)
              setMode(MODE_TEMP);
#else
#ifdef APIKEY
              if (WiFi.isConnected() && strlen(settings.mySettings.openweatherapikey) > 25 ) setMode(MODE_EXT_TEMP);
#else
#ifdef SHOW_MODE_DATE
              setMode(MODE_DATE);
#endif
#endif
#endif
              autoMode = 2;
              break;

            case 2:
#ifdef SHOW_MODE_MOONPHASE
              setMode(MODE_MOONPHASE);
#endif
              autoMode = 3;
              break;

            case 3:
#ifdef SHOW_MODE_DATE
              setMode(MODE_DATE);
#endif
              autoMode = 4;
              break;

            case 4:
#ifdef APIKEY
#ifdef SHOW_MODE_WETTER
              if ( strlen(settings.mySettings.openweatherapikey) > 25 ) setMode(MODE_WETTER);
#endif
#else
#ifdef SHOW_MODE_MOONPHASE
              setMode(MODE_MOONPHASE);
#endif
#endif
              autoMode = 0;
              break;
          }
        }
      }
    }
    // *********************************************************************************
    // ************************** Ende Auto switch modes  ******************************
    // *********************************************************************************

    // Show event in feed
#ifdef EVENT_TIME
    if (mode == MODE_TIME)
    {
      showEventTimer--;
      if (!showEventTimer )
      {
        showEventTimer = EVENT_TIME;
        if ( year() > 2010 )
        {
          Eventcheck();
        }
      }
    }
#endif
  }

  // ************************************************************************
  // Run always
  // ************************************************************************

  // schaltet für ca. 3 sek die LEDs an
  if (SHOW_TIME_BUTTON_BOOL && millis() > show_off_on_time + 3000 && mode != MODE_BLANK) {
#ifdef DEBUG
    Serial.println(F("Wieder aus nach 3 sek."));
#endif
    setMode(MODE_BLANK);
    SHOW_TIME_BUTTON_BOOL = false;
  }


  if (MODE_BUTTON_BOOL) {
    MODE_BUTTON_BOOL = false;
    if ( SHOW_TIME_BUTTON_BOOL ) {
      SHOW_TIME_BUTTON_BOOL = false;
    }
    else
    {
      if ( !SHOW_TIME_BUTTON_BOOL && mode == MODE_BLANK )
      {
        show_off_on_time = millis();
        SHOW_TIME_BUTTON_BOOL = true;
      }
      if ( mode != MODE_TIME && mode < MODE_SECONDS )
      {
        buttonTimePressed();
      }
      else
      {
        buttonModePressed();
      }
    }
  }

#ifdef SHOW_TIME_BUTTON
  if (SHOW_TIME_BUTTON_BOOL && mode == MODE_BLANK) {
    setMode(MODE_TIME);
  }
#endif

  if (mode == MODE_FEED) screenBufferNeedsUpdate = true;

#ifdef AUDIO_SOUND
  // Happy New Ansage
  if ( hny > 0 )
  {
    hny++;
    delay (10);
  }

  if ( hny == 75 )
  {
    screenBufferNeedsUpdate = true;
    Play_MP3(571, false, 450); // hans Frohes neues Jahr!
    hny++;
  }
  if ( hny == 150 )
  {
    Play_MP3(271, false, 450); // vicki Frohes neues Jahr!
    screenBufferNeedsUpdate = true;
  }
  if ( hny > 150 )
  {
    hny = 0;
  }

  // *********************************************************************
  // Stundenschlag
  // *********************************************************************
  if ( AUDIO_HOUR >= 0 )
  {
    // Happy New Year
    if ( year() > 2010 && month() == 1 && day() == 1 && hour() == 0 && minute() == 0 )
    {
      hny = 1;
      setMode(MODE_TIME);
      showEventTimer = 30;
    }
    else
    {

      // Soundtest
      if ( AUDIO_TEST ) {
        soundbase = SOUNDBASENR[testsoundfile];
      }
      //Random Sound:
      else if ( settings.mySettings.randomsound ) {
        soundbase = SOUNDBASENR[random(0, 13)];
      }
      else
      {
        // Sound pro Wochentag:
        soundbase = SOUNDBASENR[settings.mySettings.weekdaysoundfile[weekday() - 1]]; // 0 = Sonntag
      }
      // Vicki und Hans im Wechsel
      if ( soundbase == AUDIO_BASENR_VICKI_HANS )
      {
        if (vicki_hans_switch)
        {
          soundbase = AUDIO_BASENR_VICKI;
          vicki_hans_switch = false;
        }
        else
        {
          soundbase = AUDIO_BASENR_HANS;
          vicki_hans_switch = true;
        }
      }
      // 12h oder 24h Ansage
      if ( !( (soundbase == AUDIO_BASENR_VICKI || soundbase == AUDIO_BASENR_HANS ) && settings.mySettings.vickihans24h))
      {
        if ( AUDIO_HOUR > 12 ) {
          AUDIO_HOUR = AUDIO_HOUR - 12;
        }
      }
      // Singlegong
      if ( soundbase == AUDIO_BASENR_VICKI || soundbase == AUDIO_BASENR_HANS || ! settings.mySettings.singlegong )
      {
        AUDIO_FILENR = soundbase + AUDIO_HOUR;
      }
      else
      {
        AUDIO_FILENR = soundbase + 1;
      }

#ifdef DEBUG
      Serial.printf("AudioHourSound: %i AUDIO_FILENR: %i\r\n", AUDIO_HOUR, AUDIO_FILENR);
#endif
      Play_MP3(AUDIO_FILENR, false, 0);
    }
    AUDIO_HOUR = -1;
    if ( AUDIO_TEST ) {
      AUDIO_TEST = false;
      settings.mySettings.volume = volume_test_bck;
      settings.mySettings.singlegong = singlegong_bck;
      settings.mySettings.vickihans24h = vickihans24h_bck;
    }
  }
  // *********************************************************************
  // Stundenschlag Ende
  // *********************************************************************
#endif


//###########################################################################
//##################            IR-Receiver Start          ##################
//###########################################################################
#ifdef IR_RECEIVER
  // Look for IR commands
  if (irrecv.decode(&irDecodeResult))
  {
#ifdef DEBUG_IR
    Serial.print(F("IR signal: 0x"));
    serialPrintUint64(irDecodeResult.value, HEX);
    Serial.println();
#endif
    switch (irDecodeResult.value)
    {
      case IR_CODE_ONOFF:
        buttonOnOffPressed();
        break;
      case IR_CODE_TIME:
        if ( mode != MODE_TIME )
        {
          buttonTimePressed();
        }
#ifdef SHOW_MODE_ANSAGE
        else
        {
          single_mode = true;
          mode_ohne_sound = false;
          setMode(MODE_ANSAGE);
        }
#endif  
      break;
      case IR_CODE_MODE:
        buttonModePressed();
        break;
#ifdef AUDIO_SOUND
//#Lauter
      case IR_CODE_LAUTER:
        if ( settings.mySettings.volume <= 90 ) settings.mySettings.volume = settings.mySettings.volume + 10;
        Play_MP3(702, false, 0);
      break;
//#Leiser
      case IR_CODE_LEISER:
        if ( settings.mySettings.volume >= 10 ) settings.mySettings.volume = settings.mySettings.volume - 10;
        Play_MP3(702, false, 0);
      break;
#endif

//#Heller
      case IR_CODE_HELLER:
        if ( settings.mySettings.brightness <= 90 ) settings.mySettings.brightness = settings.mySettings.brightness + 10;
#ifdef AUDIO_SOUND
        Play_MP3(700, false, 0); 
#endif
#ifdef LDR
        if ( settings.mySettings.useAbc ) 
        {
           abcBrightness = map(settings.mySettings.brightness, 10, 100, MIN_BRIGHTNESS, MAX_BRIGHTNESS);
           if ( lastLdrValue <= 200 ) lastLdrValue = lastLdrValue + 99; else lastLdrValue = lastLdrValue - 99;
        }
        else
        {
           abcBrightness = map(settings.mySettings.brightness, 10, 100, MIN_BRIGHTNESS, MAX_BRIGHTNESS);
           brightness = abcBrightness;
        }
#else
        abcBrightness = map(settings.mySettings.brightness, 10, 100, MIN_BRIGHTNESS, MAX_BRIGHTNESS);
        brightness = abcBrightness;
#endif 
        ldr_update = true;
        screenBufferNeedsUpdate = true;
      break;
//#Dunkler
      case IR_CODE_DUNKLER:
        if ( settings.mySettings.brightness >= 10 ) settings.mySettings.brightness = settings.mySettings.brightness - 10;
#ifdef AUDIO_SOUND
        Play_MP3(700, false, 0);
#endif
#ifdef LDR
        if ( settings.mySettings.useAbc ) 
        {
           abcBrightness = map(settings.mySettings.brightness, 10, 100, MIN_BRIGHTNESS, MAX_BRIGHTNESS);
           if ( lastLdrValue <= 200 ) lastLdrValue = lastLdrValue + 99; else lastLdrValue = lastLdrValue - 99;
        }
        else
        {
           abcBrightness = map(settings.mySettings.brightness, 10, 100, MIN_BRIGHTNESS, MAX_BRIGHTNESS);
           brightness = abcBrightness;
        }
#else
        abcBrightness = map(settings.mySettings.brightness, 10, 100, MIN_BRIGHTNESS, MAX_BRIGHTNESS);
        brightness = abcBrightness;
#endif 
        ldr_update = true;
        screenBufferNeedsUpdate = true;
      break;

//#Wochentag
#ifdef SHOW_MODE_WEEKDAY
      case IR_CODE_WEEKDAY:
        single_mode = true;
#ifdef SINGLEMODE_MIT_SOUND
        mode_ohne_sound = false;
#else
        mode_ohne_sound = true;
#endif
        setMode(MODE_WEEKDAY);
      break;
#endif

//#Datum
#ifdef SHOW_MODE_DATE
      case IR_CODE_DATE:
        single_mode = true;
#ifdef SINGLEMODE_MIT_SOUND
        mode_ohne_sound = false;
#else
        mode_ohne_sound = true;
#endif
        setMode(MODE_DATE);
      break;
#endif
        
//#Mondphase
#ifdef SHOW_MODE_MOONPHASE
      case IR_CODE_MOND:
        single_mode = true;
#ifdef SINGLEMODE_MIT_SOUND
        mode_ohne_sound = false;
#else
        mode_ohne_sound = true;
#endif
        setMode(MODE_MOONPHASE);
      break;
#endif

//#Temp
#if defined(RTC_BACKUP) || defined(SENSOR_BME280)
      case IR_CODE_TEMP:
        single_mode = true;
#ifdef SINGLEMODE_MIT_SOUND
        mode_ohne_sound = false;
#else
        mode_ohne_sound = true;
#endif
        setMode(MODE_TEMP);
      break;
#endif


#ifdef SENSOR_BME280
//#Humidity
      case IR_CODE_HUMIDITY:
        single_mode = true;
#ifdef SINGLEMODE_MIT_SOUND
        mode_ohne_sound = false;
#else
        mode_ohne_sound = true;
#endif
        setMode(MODE_HUMIDITY);
      break;
//Luftdruckverlauf
      case IR_CODE_LUFTDRUCK:
        single_mode = true;
#ifdef SINGLEMODE_MIT_SOUND
        mode_ohne_sound = false;
#else
        mode_ohne_sound = true;
#endif
        setMode(MODE_LUFTDRUCK);
      break;        
#endif

//#Openweather
#ifdef APIKEY
//#Wetter
      case IR_CODE_WETTER:
        single_mode = true;
#ifdef SINGLEMODE_MIT_SOUND
        mode_ohne_sound = false;
#else
        mode_ohne_sound = true;
#endif
        setMode(MODE_WETTER);
      break;
//#Ext_Temp
      case IR_CODE_EXT_TEMP:
        single_mode = true;
#ifdef SINGLEMODE_MIT_SOUND
        mode_ohne_sound = false;
#else
        mode_ohne_sound = true;
#endif
        setMode(MODE_EXT_TEMP);
      break;  
//#Ext_Humidity
      case IR_CODE_EXT_HUMIDITY:
        single_mode = true;
#ifdef SINGLEMODE_MIT_SOUND
        mode_ohne_sound = false;
#else
        mode_ohne_sound = true;
#endif
        setMode(MODE_EXT_HUMIDITY);
      break;  
#endif
//#Sekunden
#ifdef SHOW_MODE_SECONDS
      case IR_CODE_SECONDS:
        single_mode = true;
#ifdef SINGLEMODE_MIT_SOUND
        mode_ohne_sound = false;
#else
        mode_ohne_sound = true;
#endif
        setMode(MODE_SECONDS);
      break;
#endif
    }
    irrecv.resume();
  }
#endif
//###########################################################################
//##################           IR-Receiver  Ende           ##################
//###########################################################################

 
// Render a new screenbuffer if needed

  if (screenBufferNeedsUpdate)
  {
    screenBufferNeedsUpdate = false;
    // Save old screenbuffer
    for (uint8_t i = 0; i <= 9; i++) matrixOld[i] = matrix[i];
    if ( mode != MODE_TIME ) ModeSequenz++;
    modeExtraTime = 0;
    switch (mode)
    {
      case MODE_TIME:
        renderer.clearScreenBuffer(matrix);

#ifdef FRONTCOVER_BINARY
        matrix[0] = 0b1111000000000000;
        matrix[1] = aktHour << 5;
        matrix[2] = aktMinute << 5;
        matrix[3] = aktSecond << 5;
        matrix[5] = 0b1111000000000000;
        matrix[6] = aktDay << 5;
        matrix[7] = month() << 5;
        matrix[8] = year() - 2000 << 5;
#else
        // Hier wird die Uhrzeit gesetzt:
        renderer.setTime(aktHour, aktMinute, matrix);
        renderer.setCorners(aktMinute, matrix);
        if (!settings.mySettings.itIs && ((aktMinute / 5) % 6)) renderer.clearEntryWords(matrix);
#endif
#ifdef ALARM_LED_COLOR  // <----- hier einfügen
#if defined(BUZZER) || defined(AUDIO_SOUND)
        if (settings.mySettings.alarm1 || settings.mySettings.alarm2 || alarmTimerSet) renderer.setAlarmLed(matrix);
#endif
#endif
        break;
#ifdef SHOW_MODE_ANSAGE
      case MODE_ANSAGE:
#ifdef DEBUG
        if ( ModeSequenz == 1 ) Serial.println(F("************ Mode Ansage"));
#endif
        modeExtraTime = -200;
        if ( !single_mode ) 
        {
          renderer.clearScreenBuffer(matrix);
          matrix[0] = 0b0000111000000000;
          matrix[1] = 0b0011111110000000;
          matrix[2] = 0b0111111111000000;
          matrix[3] = 0b0110111011000000;
          matrix[4] = 0b1110111011100000;
          matrix[5] = 0b1111111111100000;
          matrix[6] = 0b0101111101000000;
          matrix[7] = 0b0110000011000000;
          matrix[8] = 0b0011000110000000;
          matrix[9] = 0b0000111000000000;
        }
#ifdef AUDIO_SOUND
        if ( ModeSequenz == 3 && !mode_ohne_sound ) {
          Zeitansage(ANSAGEBASE, 0);
        }
#endif
        break;
#endif
#ifdef SHOW_MODE_SECONDS
      case MODE_SECONDS:
#ifdef DEBUG
        if ( ModeSequenz == 1 ) Serial.println(F("************ Mode Sekunden"));
#endif
        modeExtraTime = 5000;
#ifdef AUDIO_SOUND
        if ( ModeSequenz == 2 && !mode_ohne_sound ) {
          AUDIO_FILENR = ANSAGEBASE + 30;
          Play_MP3(AUDIO_FILENR, false, 0);
        }
#endif
        renderer.clearScreenBuffer(matrix);
        renderer.setCorners(aktMinute, matrix);
        for (uint8_t i = 0; i <= 6; i++)
        {
          uint8_t b = pgm_read_byte(&numbersBig[aktSecond / 10][i]);
          matrix[1 + i] |= b << 11;
          b = pgm_read_byte(&numbersBig[aktSecond % 10][i]);
          matrix[1 + i] |= b << 5;
          //				matrix[1 + i] |= numbersBig[aktSecond / 10][i] << 11;
          //				matrix[1 + i] |= numbersBig[aktSecond % 10][i] << 5;
        }
        break;
#endif
#ifdef SHOW_MODE_WEEKDAY
      case MODE_WEEKDAY:
#ifdef DEBUG
        if ( ModeSequenz == 1 ) Serial.println(F("************ Mode Wochentag"));
#endif
        modeExtraTime = -500;
#ifdef AUDIO_SOUND
        if ( ModeSequenz == 2 && !mode_ohne_sound ) {
          Wochentagansage(ANSAGEBASE, 0);
        }
#endif
        renderer.clearScreenBuffer(matrix);  
        renderer.setSmallText(String((char)pgm_read_byte(&sWeekday[weekday()][0])) + String((char)pgm_read_byte(&sWeekday[weekday()][1])), TEXT_POS_MIDDLE, matrix);
        break;
#endif
#ifdef SHOW_MODE_DATE
      case MODE_DATE:
#ifdef DEBUG
        if ( ModeSequenz == 1 ) Serial.println(F("************ Mode Datum"));
#endif
#ifdef AUDIO_SOUND
        if ( ModeSequenz == 2 && !mode_ohne_sound ) {
          Datumsansage(ANSAGEBASE, 0);
        }
#endif
        modeExtraTime = 2000;
        renderer.clearScreenBuffer(matrix);
        if (aktDay < 10)
          renderer.setSmallText(("0" + String(aktDay)), TEXT_POS_TOP, matrix);
        else
          renderer.setSmallText(String(aktDay), TEXT_POS_TOP, matrix);
        if (month() < 10)
          renderer.setSmallText(("0" + String(month())), TEXT_POS_BOTTOM, matrix);
        else
          renderer.setSmallText(String(month()), TEXT_POS_BOTTOM, matrix);
        //			renderer.setPixelInScreenBuffer(5, 4, matrix); // hier ein Punkt nochmal am Ende ??
        //			renderer.setPixelInScreenBuffer(5, 9, matrix); // hier ein Punkt nochmal am Ende ??

        break;
#endif

#ifdef SHOW_MODE_MOONPHASE
      case MODE_MOONPHASE:
#ifdef DEBUG
        if ( ModeSequenz == 1 ) Serial.println(F("************ Mode Mondphase"));
#endif
        modeExtraTime = 3000;
#ifdef AUDIO_SOUND
        if ( ModeSequenz == 1 && !mode_ohne_sound ) {
          AUDIO_FILENR = ANSAGEBASE + 33;
          Play_MP3(AUDIO_FILENR, false, 0);
        }
        if ( ModeSequenz == 3 && !mode_ohne_sound ) {
          if ( moonphase == 0 ) AUDIO_FILENR = ANSAGEBASE + 70; // Neumond
          if ( moonphase == 11 ) AUDIO_FILENR = ANSAGEBASE + 72; // Vollmond
          if ( moonphase > 0 && moonphase < 11 ) AUDIO_FILENR = ANSAGEBASE + 71; // zunehmend
          if ( moonphase > 11 && moonphase < 22 ) AUDIO_FILENR = ANSAGEBASE + 73; // abnehmend
          Play_MP3(AUDIO_FILENR, false, 0);
        }
#endif
        if ( ModeSequenz == 1 ) renderer.clearScreenBuffer(matrix);
        if ( ModeSequenz <= 5 ) {
          ani_moonphase = moonphase - 5 + ModeSequenz;

          if ( ani_moonphase < 0 ) ani_moonphase = 22 + ani_moonphase;
#ifdef DEBUG
          Serial.println("ani_moonphase: " + String(ani_moonphase));
#endif
          for (uint8_t i = 0; i <= 9; i++)
          {
            matrixOld[i] = matrix[i];
            //         matrix[i] = MONDMATRIX[ani_moonphase][i];
            matrix[i] = pgm_read_word(&MONDMATRIX[ani_moonphase][i]);
          }
        }
        break;
#endif

#if defined(RTC_BACKUP) || defined(SENSOR_BME280)
      case MODE_TEMP:
#ifdef DEBUG
        if ( ModeSequenz == 1 )
        {
          Serial.println(F("************ Mode Raumtemperatur"));
          Serial.println("Raumtemperatur:" + String(roomTemperature));
        }
#endif
#ifdef AUDIO_SOUND
        if ( ModeSequenz == 2 && !mode_ohne_sound ) {
          Temperaturansage(ANSAGEBASE, true, roomTemperature, 0);
        }
#endif
        renderer.clearScreenBuffer(matrix);
        if (roomTemperature == 0)
        {
          matrix[0] = 0b0000000001000000;
          matrix[1] = 0b0000000011100000;
          matrix[2] = 0b0000000010100000;
          matrix[3] = 0b0000000011100000;
        }
        if (roomTemperature > 0)
        {
          matrix[0] = 0b0000000001000000;
          matrix[1] = 0b0100000011100000;
          matrix[2] = 0b1110000010100000;
          matrix[3] = 0b0100000011100000;
        }
        if (roomTemperature < 0)
        {
          matrix[0] = 0b0000000001000000;
          matrix[1] = 0b0000000011100000;
          matrix[2] = 0b1110000010100000;
          matrix[3] = 0b0000000011100000;
        }
        renderer.setSmallText(String(int(abs(roomTemperature) + 0.5)), TEXT_POS_BOTTOM, matrix);
        break;
#ifdef SENSOR_BME280
      case MODE_HUMIDITY:
#ifdef DEBUG
        if ( ModeSequenz == 1 )
        {
          Serial.println(F("************ Mode Luftfeuchtigkeit innen"));
          Serial.println("Luftfeuchtigkeit innen:" + String(roomHumidity));
        }
#endif
#ifdef AUDIO_SOUND
        if ( ModeSequenz == 2 && !mode_ohne_sound ) {
          Humidityansage(ANSAGEBASE, true, roomHumidity, 0);
        }
#endif
        renderer.clearScreenBuffer(matrix);
        renderer.setSmallText(String(int(roomHumidity + 0.5)), TEXT_POS_TOP, matrix);
        matrix[6] = 0b0100100001000000;
        matrix[7] = 0b0001000011100000;
        matrix[8] = 0b0010000010100000;
        matrix[9] = 0b0100100011100000;
        break;
#endif
#endif


#ifdef APIKEY
        // #################### WETTER START #################
#ifdef SHOW_MODE_WETTER
        if ( strlen(settings.mySettings.openweatherapikey) > 25 )
        {
        case MODE_WETTER:

          if ( ModeSequenz == 1 )
          {
            WetterSequenz = ModeSequenz;
            WetterAnsageSchritt = ModeSequenz; // Start
          }
#ifdef DEBUG
          if ( ModeSequenz == 1 )
          {
            Serial.println(F("************ Mode Wetter"));
          }
#endif

          // ############# Wetteransage Start
#ifdef AUDIO_SOUND

          if ( ModeSequenz == 2 && !mode_ohne_sound ) {
            AudioBufferClear();
            AudioBufferIn(ANSAGEBASE + 400); // Wetter
            PABStatus = PlayAudioBuffer(0);
            AUDIO_FILENR = ANSAGEBASE + getWeatherSound(outdoorWeather.weatherid1); // Wetterlage 1
            AudioBufferIn(AUDIO_FILENR);
            WetterAnsageSchritt = 2; //Start Ansage Wetterlage
          }
          //#ifdef DEBUG
          //      if ( digitalRead(PIN_AUDIO_BUSY) ) Serial.printf("BusyPin! %i\n",millis() - wetteransagets);
          //#endif
          if ( WetterAnsageSchritt == 2 && PlayAudioBuffer(0) == 2 && !mode_ohne_sound ) {
            if ( outdoorWeather.weatherid1 != 771 && outdoorWeather.weatherid1 != 781 && outdoorWeather.weatherid2 != 771 && outdoorWeather.weatherid2 != 781 )
            {
              if ( outdoorWeather.windspeed <= 0.5 )                                     AUDIO_FILENR = ANSAGEBASE + WETTERSOUNDBASE + 80;      //windstill
              if ( outdoorWeather.windspeed > 0.5 && outdoorWeather.windspeed <= 4.0 )   AUDIO_FILENR = ANSAGEBASE + WETTERSOUNDBASE + 81;      //leichte Brise
              if ( outdoorWeather.windspeed > 4.0 && outdoorWeather.windspeed <= 8.0 )   AUDIO_FILENR = ANSAGEBASE + WETTERSOUNDBASE + 82;      //mäßiger-schwacher Wind
              if ( outdoorWeather.windspeed > 8.0 && outdoorWeather.windspeed <= 14.0 )  AUDIO_FILENR = ANSAGEBASE + WETTERSOUNDBASE + 83;      //starker Wind
              if ( outdoorWeather.windspeed > 14.0 && outdoorWeather.windspeed <= 18.0 ) AUDIO_FILENR = ANSAGEBASE + WETTERSOUNDBASE + 84;      //stürmischer Wind
              if ( outdoorWeather.windspeed > 18 )                                       AUDIO_FILENR = ANSAGEBASE + WETTERSOUNDBASE + 85;      //Sturm
              AudioBufferIn(AUDIO_FILENR);
            }
            WetterAnsageSchritt = 3;  //Start Ansage Wetterlage Load Ansage Wind
          }

          if ( WetterAnsageSchritt == 3 && PlayAudioBuffer(0) == 2 && !mode_ohne_sound  &&  WetterSequenz < 2000 )
          {
            WetterAnsageSchritt = 4; // Start Ansage Wind
          }
          if ( WetterAnsageSchritt == 4 && !Soundaktiv() )
          {
            WetterAnsageSchritt = 5; // Ende Ansage Wind
          }

          if ( WetterSequenz == 2005 && !mode_ohne_sound ) {
            AUDIO_FILENR = ANSAGEBASE + getWeatherSound(outdoorWeather.weatherid2);
            AudioBufferIn(AUDIO_FILENR);             // Wetterlage 2 (wenn vorhanden)
            PABStatus = PlayAudioBuffer(0);
            WetterAnsageSchritt = 11; //Start Ansage Wetterlage2
          }
          if ( WetterAnsageSchritt == 11 && !Soundaktiv() && !mode_ohne_sound )
          {
            WetterAnsageSchritt = 12; //Ende Ansage Wetterlage2
          }

#endif
          // ############# Wetteransage Ende

          if ( WetterSequenz == 1 || WetterSequenz == 2001 )
          {
            animation = F("WETTER_");
            if ( WetterSequenz == 1 ) animation += getWeatherIcon(outdoorWeather.weathericon1);
            if ( WetterSequenz == 2001 ) animation += getWeatherIcon(outdoorWeather.weathericon2);
            animation.toUpperCase();
#ifdef DEBUG
            Serial.printf("Wetteranimantion: %s ", animation.c_str());
#endif
            if ( loadAnimation(animation) )
            {
              WetterSequenz++;
              akt_aniframe = 0;
              akt_aniloop = 0;
              frame_fak = 0;
            }
            else            // Wetteranimation wurde nicht gefunden - sollte eigentlich nicht vorkommen!
            {
              WetterSequenz = 9999;  //Ende
              modeExtraTime = SHOW_MODE_TIMEOUT * -1;
#ifdef AUDIO_SOUND
              if ( !mode_ohne_sound )
              {
                Play_MP3(99, true, 0); //Stop
              }
#endif
            }
          }
#ifdef DEBUG
          if ( !mode_ohne_sound ) Serial.printf("WetterAnsageSchritt: %i\n", WetterAnsageSchritt);
#endif
          if ( ( WetterSequenz > 1 && WetterSequenz < 2000 )  ||  ( WetterSequenz > 2001 && WetterSequenz < 9999 ) )
          {
            if ( showAnimation(brightness) && ( WetterAnsageSchritt < 5 || WetterAnsageSchritt == 10 || WetterAnsageSchritt == 11) )
            {
              modeExtraTime = 500;
              modeTimeout = millis();
              WetterSequenz++;
            }
            else
            {
              delay(100);
              if ( WetterSequenz < 2000 && !mode_ohne_sound && outdoorWeather.weathericon2.length() > 1 && outdoorWeather.weathericon1 != outdoorWeather.weathericon2  )
              {
#ifdef DEBUG
                Serial.println(F("2.WetterLage"));
#endif
                WetterAnsageSchritt = 10;  // 2. Wetterlage
                WetterSequenz = 2001;
              }
              else
              {
#ifdef DEBUG
                Serial.println(F("Ende Wetter"));
#endif
                modeExtraTime = SHOW_MODE_TIMEOUT * -1;
                modeTimeout = millis();
                delay(10);
                WetterSequenz = 0;
                WetterAnsageSchritt = 0;
              }
            }
          }
          break;
        }
#endif
      // ######################## WETTER ENDE ##############
      case MODE_EXT_TEMP:
#ifdef DEBUG
        if ( ModeSequenz == 1 )
        {
          Serial.println(F("************ Mode Aussentemperatur"));
          Serial.println("Aussentemperatur: " + String(outdoorWeather.temperature));
        }
#endif
#ifdef AUDIO_SOUND
        if ( ModeSequenz == 2 && !mode_ohne_sound ) {
          Temperaturansage(ANSAGEBASE, false, outdoorWeather.temperature, 0);
        }
#endif
        renderer.clearScreenBuffer(matrix);
        if (outdoorWeather.temperature > 0)
        {
          matrix[1] = 0b0100000000000000;
          matrix[2] = 0b1110000000000000;
          matrix[3] = 0b0100000000000000;
        }
        if (outdoorWeather.temperature < 0)
        {
          matrix[2] = 0b1110000000000000;
        }
        renderer.setSmallText(String(int(abs(outdoorWeather.temperature) + 0.5)), TEXT_POS_BOTTOM, matrix);
        break;
      case MODE_EXT_HUMIDITY:
        modeExtraTime = 2000;
#ifdef DEBUG
        if ( ModeSequenz == 1 )
        {
          Serial.println(F("************ Mode Luftfeuchtigkeit aussen"));
          Serial.println("Luftfeuchtigkeit aussen: " + String(outdoorWeather.humidity));
        }
#endif
#ifdef AUDIO_SOUND
        if ( ModeSequenz == 2 && !mode_ohne_sound ) {
          Humidityansage(ANSAGEBASE, false, outdoorWeather.humidity, 0);
        }
#endif
        renderer.clearScreenBuffer(matrix);
        if (outdoorWeather.humidity < 100)
          renderer.setSmallText(String(outdoorWeather.humidity), TEXT_POS_TOP, matrix);
        else
        {
          matrix[0] = 0b0010111011100000;
          matrix[1] = 0b0110101010100000;
          matrix[2] = 0b0010101010100000;
          matrix[3] = 0b0010101010100000;
          matrix[4] = 0b0010111011100000;
        }
        matrix[6] = 0b0100100000000000;
        matrix[7] = 0b0001000000000000;
        matrix[8] = 0b0010000000000000;
        matrix[9] = 0b0100100000000000;
        break;
#endif

#ifdef SENSOR_BME280
      case MODE_LUFTDRUCK:
#ifdef DEBUG
        if ( ModeSequenz == 1 ) Serial.println(F("************ Mode Luftdruckverlauf"));
#endif
        modeExtraTime = 2000;
        renderer.clearScreenBuffer(matrix);
        Luftdruckverlauf(matrix);
#ifdef AUDIO_SOUND
        AUDIO_FILENR = ANSAGEBASE + 64;   //Luftdruckverlauf
        if ( ModeSequenz == 3 && !mode_ohne_sound ) {
          Play_MP3(AUDIO_FILENR, true, 0);
          AUDIO_FILENR = ANSAGEBASE + luftdrucktendenz_soundbase;
          Play_MP3(AUDIO_FILENR, true, 0);
        }
#endif

        break;
#endif

#if defined(BUZZER) || defined(AUDIO_SOUND)
      case MODE_TIMER:                      // Timer
#ifdef AUDIO_SOUND
        AUDIO_FILENR = ANSAGEBASE + 38;  //Timer
        if ( ModeSequenz == 1 && !mode_ohne_sound ) {
          Play_MP3(AUDIO_FILENR, false, 0);
        }
#endif
        renderer.clearScreenBuffer(matrix);
        renderer.setSmallText("TI", TEXT_POS_TOP, matrix);
        renderer.setSmallText(String(alarmTimer), TEXT_POS_BOTTOM, matrix);
        break;
#endif

#ifdef SHOW_MODE_TEST
      case MODE_TEST:
        renderer.clearScreenBuffer(matrix);
        if (testColumn == 10)
          testColumn = 0;
        matrix[testColumn] = 0b1111111111110000;
        testColumn++;
        break;
      case MODE_RED:
      case MODE_GREEN:
      case MODE_BLUE:
      case MODE_WHITE:
        renderer.setAllScreenBuffer(matrix);
        break;
#endif
      case MODE_BLANK:
        renderer.clearScreenBuffer(matrix);
        break;

      case MODE_IP:
        if ( ModeSequenz == 1 )
        {
          WiFi.isConnected() ? feedText = "  IP: " : feedText = "  AP-IP: ";

          feedText += String(myIP[0]) + '.' + String(myIP[1]) + '.' + String(myIP[2]) + '.' + String(myIP[3]) + "   ";

          feedPosition = 0;
          feedColor = WHITE;
#ifdef AUDIO_SOUND
          myIPidx = 0;
#endif
        }
#ifdef AUDIO_SOUND
        if ( feedPosition == 0 ) {
          AudioBufferClear();
          AUDIO_FILENR = ANSAGEBASE + 47;  //IP-Adresse
          Play_MP3(AUDIO_FILENR, false, 0);
          myIPidx = 0;
        }
#ifdef DEBUG
        Serial.printf("FeedPos: %i  FeedPosChar: ", feedPosition);
        Serial.println(feedText[feedPosition]);
#endif
        if ( feedText[feedPosition] == ':' ) ZahltoAudioBuffer(ANSAGEBASE, myIP[myIPidx]);

        if ( feedText[feedPosition + 2] == '.' )
        {
          AudioBufferIn(ANSAGEBASE + 57); // Punkt
          myIPidx++;
          ZahltoAudioBuffer(ANSAGEBASE, myIP[myIPidx]);
        }
        PABStatus = PlayAudioBuffer(0) ;

#endif

      case MODE_FEED:
        if ( feedPosition == 0 ) {

#ifdef DEBUG
          Serial.println(feedText);
#endif
          feedText.replace("\xC3\x84", "\x7F"); // Ä
          feedText.replace("\xC3\xA4", "\x80"); // ä
          feedText.replace("\xC3\x9C", "\x81"); // Ü
          feedText.replace("\xC3\xBC", "\x82"); // ü
          feedText.replace("\xC3\x96", "\x83"); // Ö
          feedText.replace("\xC3\xB6", "\x84"); // ö
          feedText.replace("\xC3\x9F", "\x85"); // ß
        }
#ifdef DEBUG_EVENTS
        Serial.printf("Eventzeichen: %c : %x\n", feedText[feedPosition], feedText[feedPosition]);
#endif
        if ( feedText[feedPosition] < 32     || feedText[feedPosition]     > 133 ) feedText[feedPosition]     = '.';
        if ( feedText[feedPosition + 1] < 32 || feedText[feedPosition + 1] > 133 ) feedText[feedPosition + 1] = '.';
        if ( feedText[feedPosition + 2] < 32 || feedText[feedPosition + 2] > 133 ) feedText[feedPosition + 2] = '.';

        for (uint8_t y = 0; y <= 5; y++)
        {
          renderer.clearScreenBuffer(matrix);
          for (uint8_t z = 0; z <= 6; z++)
          {
            uint8_t b = pgm_read_byte(&lettersBig[feedText[feedPosition] - 32][z]);
            //					matrix[2 + z] |= (lettersBig[feedText[feedPosition] - 32][z] << 11 + y) & 0b1111111111100000;
            matrix[2 + z] |= (b << 11 + y) & 0b1111111111100000;
            b = pgm_read_byte(&lettersBig[feedText[feedPosition + 1] - 32][z]);
            //					matrix[2 + z] |= (lettersBig[feedText[feedPosition + 1] - 32][z] << 5 + y) & 0b1111111111100000;
            matrix[2 + z] |= (b << 5 + y) & 0b1111111111100000;
            b = pgm_read_byte(&lettersBig[feedText[feedPosition + 2] - 32][z]);
            //					matrix[2 + z] |= (lettersBig[feedText[feedPosition + 2] - 32][z] << y - 1) & 0b1111111111100000;
            matrix[2 + z] |= (b << y - 1) & 0b1111111111100000;
          }
          writeScreenBuffer(matrix, feedColor, brightness);
          delay(FEED_SPEED);
          handle_Webserver(__LINE__);
          if ( mode == MODE_IP )
          {
            delay(FEED_SPEED / 2);
#ifdef AUDIO_SOUND
            if ( PABStatus > 0 ) PABStatus = PlayAudioBuffer(0);
#endif
          }
        }
        feedPosition++;
        if (feedPosition == feedText.length() - 2)
        {
          feedPosition = 0;
          if ( post_event_ani )
          {
            post_event_ani = false;
            while ( showAnimation(brightness) )
            {
#ifdef DEBUG_EVENTS
              Serial.println("Starte Event Post Animation: " + String(myanimation.name) + " Loop: " +  String(akt_aniloop) + " Frame: " + String(akt_aniframe) );
#endif
            }
          }

#ifdef AUDIO_SOUND
          if ( audio_stop_nach_feed ) Play_MP3(99, false, 0); //Stop
          audio_stop_nach_feed = true;
#endif
          if ( events[0].aktiv ) events[0].aktiv  = false;  // Setze Event 0 inaktiv.
          if ( mode != MODE_IP ) setMode(MODE_TIME);
        }
        break;
      case MODE_SHOWANIMATION:
        break;
      case MODE_MAKEANIMATION:
        break;
      case MODE_ALARMANIMATION:
        break;
    }

    // turn off LED behind IR-sensor
#ifdef IR_LETTER_OFF
    renderer.unsetPixelInScreenBuffer(IR_LETTER_X, IR_LETTER_Y - 1, matrix);
#endif

    //debugScreenBuffer(matrixOld);
#ifdef DEBUG_MATRIX
    debugScreenBuffer(matrix);
#endif

    // write screenbuffer to display

    switch (mode)
    {
      case MODE_BLANK:
        writeScreenBufferFade(matrixOld, matrix, settings.mySettings.color, brightness);
        break;
      case MODE_TIME:
        if ( ldr_update )
        {
          writeScreenBuffer(matrix, settings.mySettings.color, brightness);
        }
        //#ifdef SHOW_TIME_BUTTON
        else if (SHOW_TIME_BUTTON_BOOL )
        {
          renderer.clearScreenBuffer(matrixOld);
          //        writeScreenBuffer(matrix, settings.mySettings.color, brightness);
          writeScreenBufferFade(matrixOld, matrix, settings.mySettings.color, brightness);
        }
        //#endif
        else if ( playanimation )
        {
          if ( loadAnimation(animation) )
          {
            akt_aniframe = 0;
            akt_aniloop = 0;
            frame_fak = 0;
#ifdef DEBUG
            Serial.println("Starte StundeMinute Animation: " + String(myanimation.name) );
#endif
            while ( showAnimation(brightness) ) {}
          }
          playanimation = false;
          if ( settings.mySettings.colorChange == COLORCHANGE_FIVE || settings.mySettings.colorChange == COLORCHANGE_HOUR ) settings.mySettings.color = aktHour;
          if ( settings.mySettings.corner_colorChange == COLORCHANGE_MAIN ) settings.mySettings.corner_color = settings.mySettings.color;
          renderer.clearScreenBuffer(matrixOld);
          writeScreenBuffer(matrix, settings.mySettings.color, brightness);
          runTransitionOnce = false;
          screenBufferNeedsUpdate = false;
        }
        else if ( hny > 0 )
        {
          farbenmeer(matrixOld, matrix, settings.mySettings.color, brightness);
        }
        else if ( lastMode == MODE_ALARMANIMATION )
        {
          writeScreenBuffer(matrix, settings.mySettings.color, brightness);
        }
        else
        {
          if (aktMinute % 5 != 0 )
          {
            writeScreenBufferFade(matrixOld, matrix, settings.mySettings.color, brightness);
          }
          else
          {
            akt_transition = settings.mySettings.transition;
            if ( settings.mySettings.transition == TRANSITION_RANDOM )
            {
              akt_transition_old = akt_transition;
              for (uint8_t i = 0; i <= 20; i++)
              {
                akt_transition = random(TRANSITION_NORMAL + 1, TRANSITION_MAX);
                if ( akt_transition != akt_transition_old ) break;
              }
            }
            if ( settings.mySettings.transition == TRANSITION_ALLE_NACHEINANDER )
            {
              akt_transition_old++;
              if ( akt_transition_old >= TRANSITION_MAX ) akt_transition_old = TRANSITION_NORMAL + 1;
              akt_transition = akt_transition_old;
            }

            if (akt_transition == TRANSITION_NORMAL)
              writeScreenBuffer(matrix, settings.mySettings.color, brightness);
            else if (akt_transition == TRANSITION_MOVEUP)
              moveScreenBufferUp(matrixOld, matrix, settings.mySettings.color, brightness);
            else if (akt_transition == TRANSITION_MOVEDOWN)
              moveScreenBufferDown(matrixOld, matrix, settings.mySettings.color, brightness);
            else if (akt_transition == TRANSITION_MOVELEFT)
              moveScreenBufferLeft(matrixOld, matrix, settings.mySettings.color, brightness);
            else if (akt_transition == TRANSITION_MOVERIGHT)
              moveScreenBufferRight(matrixOld, matrix, settings.mySettings.color, brightness);
            else if (akt_transition == TRANSITION_MOVELEFTDOWN)
              moveScreenBufferLeftDown(matrixOld, matrix, settings.mySettings.color, brightness);
            else if (akt_transition == TRANSITION_MOVERIGHTDOWN)
              moveScreenBufferRightDown(matrixOld, matrix, settings.mySettings.color, brightness);
            else if (akt_transition == TRANSITION_MOVECENTER)
              moveScreenBufferCenter(matrixOld, matrix, settings.mySettings.color, brightness);
            else if (akt_transition == TRANSITION_FADE)
              writeScreenBufferFade(matrixOld, matrix, settings.mySettings.color, brightness);
            else if (akt_transition == TRANSITION_FARBENMEER)
              farbenmeer(matrixOld, matrix, settings.mySettings.color, brightness);
            else if (akt_transition == TRANSITION_MATRIX)
              matrix_regen(matrixOld, matrix, settings.mySettings.color, brightness);
            else if (akt_transition == TRANSITION_SPIRALE_LINKS)
              moveSeriell(matrixOld, matrix, settings.mySettings.color, brightness, SPIRALE_LINKS);
            else if (akt_transition == TRANSITION_ZEILENWEISE)
              moveSeriell(matrixOld, matrix, settings.mySettings.color, brightness, ZEILENWEISE);
            else if (akt_transition == TRANSITION_SPIRALE_RECHTS)
              moveSeriell(matrixOld, matrix, settings.mySettings.color, brightness, SPIRALE_RECHTS);
            else if (akt_transition == TRANSITION_MITTE_LINKSHERUM)
              moveSeriell(matrixOld, matrix, settings.mySettings.color, brightness, MITTE_LINKSHERUM);
            else if (akt_transition == TRANSITION_REGENBOGEN)
              regenbogen(matrixOld, matrix, settings.mySettings.color, brightness);
            else if (akt_transition == TRANSITION_QUADRATE)
              quadrate(matrixOld, matrix, settings.mySettings.color, brightness);
            else if (akt_transition == TRANSITION_KREISE)
              kreise(matrixOld, matrix, settings.mySettings.color, brightness);
            else
            {
              writeScreenBuffer(matrix, settings.mySettings.color, brightness);
            }
          }
        }

        break;
      case MODE_ANSAGE:
        //      writeScreenBufferFade(matrixOld, matrix, YELLOW, brightness);
        if ( !single_mode ) 
        {
          writeScreenBuffer(matrix, YELLOW, brightness);
        }
        break;
#ifdef APIKEY

      case MODE_WETTER:
        break;
      case MODE_EXT_TEMP:
        if ( strlen(settings.mySettings.openweatherapikey) > 25 )
        {
          if (outdoorWeather.temperature < -10 ) Tempcolor = VIOLET;
          else if (outdoorWeather.temperature >= -10  && outdoorWeather.temperature < -5) Tempcolor = BLUE;
          else if (outdoorWeather.temperature >= -5  && outdoorWeather.temperature < 0) Tempcolor = LIGHTBLUE;
          else if (outdoorWeather.temperature >= 0  && outdoorWeather.temperature < 5) Tempcolor = CYAN;
          else if (outdoorWeather.temperature >= 5  && outdoorWeather.temperature < 10) Tempcolor = MINTGREEN;
          else if (outdoorWeather.temperature >= 10  && outdoorWeather.temperature < 15) Tempcolor = GREEN;
          else if (outdoorWeather.temperature >= 15  && outdoorWeather.temperature < 20) Tempcolor = GREENYELLOW;
          else if (outdoorWeather.temperature >= 20  && outdoorWeather.temperature < 25) Tempcolor = YELLOW;
          else if (outdoorWeather.temperature >= 25  && outdoorWeather.temperature < 30) Tempcolor = ORANGE;
          else if (outdoorWeather.temperature >= 30  && outdoorWeather.temperature < 40) Tempcolor = RED;
          else if (outdoorWeather.temperature >= 40  ) Tempcolor = RED_50;
          writeScreenBuffer(matrix, Tempcolor, brightness);
        }
        break;
#endif
#ifdef SENSOR_BME280
      case MODE_TEMP:
        if (roomTemperature < 10 ) Tempcolor = VIOLET;
        else if (roomTemperature >= 10  && roomTemperature < 12) Tempcolor = BLUE;
        else if (roomTemperature >= 12  && roomTemperature < 15) Tempcolor = LIGHTBLUE;
        else if (roomTemperature >= 15  && roomTemperature < 17) Tempcolor = CYAN;
        else if (roomTemperature >= 17  && roomTemperature < 19) Tempcolor = MINTGREEN;
        else if (roomTemperature >= 19  && roomTemperature < 20) Tempcolor = GREEN;
        else if (roomTemperature >= 20  && roomTemperature < 22) Tempcolor = GREENYELLOW;
        else if (roomTemperature >= 22  && roomTemperature < 24) Tempcolor = YELLOW;
        else if (roomTemperature >= 24  && roomTemperature < 27) Tempcolor = ORANGE;
        else if (roomTemperature >= 27  && roomTemperature < 30) Tempcolor = RED;
        else if (roomTemperature >= 30  ) Tempcolor = RED_50;
        writeScreenBuffer(matrix, Tempcolor, brightness);
        break;
#endif
      case MODE_WEEKDAY:
        if ( weekday() == 1 ) writeScreenBuffer(matrix, RED_25, brightness); //Sonntag
        if ( weekday() == 7 ) writeScreenBuffer(matrix, GREEN_25, brightness); //Samstag
        if ( weekday() > 1 && weekday() < 7 ) writeScreenBuffer(matrix, YELLOW_50, brightness); //Wochentag

        break;
      case MODE_DATE:
        writeScreenBuffer(matrix, YELLOW, brightness);
        break;
      case MODE_MOONPHASE:
        writeScreenBufferFade(matrixOld, matrix, ORANGE, brightness);
        //      writeScreenBuffer(matrix, ORANGE, brightness);
        break;

#ifdef SHOW_MODE_TEST
      case MODE_TEST:
#ifdef DEBUG
        if ( ModeSequenz == 1 ) Serial.println(F("************ Mode Matrixtest"));
#endif
#ifdef AUDIO_SOUND
        AUDIO_FILENR = ANSAGEBASE + 39; //Matrixtest
        if ( ModeSequenz == 1 && !mode_ohne_sound ) {
          Play_MP3(AUDIO_FILENR, false, 0);
        }
#endif
        cornercolorold = settings.mySettings.corner_color;
        settings.mySettings.corner_color = WHITE;
        writeScreenBuffer(matrix, WHITE, TEST_BRIGHTNESS);
        settings.mySettings.corner_color = cornercolorold;
        break;

      case MODE_RED:
#ifdef DEBUG
        if ( ModeSequenz == 1 ) Serial.println(F("************ Mode rot"));
#endif
#ifdef AUDIO_SOUND
        AUDIO_FILENR = ANSAGEBASE + 43;  //Alles rot
        if ( ModeSequenz == 2 && !mode_ohne_sound ) {
          Play_MP3(AUDIO_FILENR, false, 0);
        }
#endif
        cornercolorold = settings.mySettings.corner_color;
        settings.mySettings.corner_color = RED;
        writeScreenBuffer(matrix, RED, TEST_BRIGHTNESS);
        settings.mySettings.corner_color = cornercolorold;
        break;

      case MODE_GREEN:
#ifdef DEBUG
        if ( ModeSequenz == 1 ) Serial.println(F("************ Mode grün"));
#endif
#ifdef AUDIO_SOUND
        AUDIO_FILENR = ANSAGEBASE + 44; //Alles grün
        if ( ModeSequenz == 2 && !mode_ohne_sound )  {
          Play_MP3(AUDIO_FILENR, false, 0);
        }
#endif
        cornercolorold = settings.mySettings.corner_color;
        settings.mySettings.corner_color = GREEN;
        writeScreenBuffer(matrix, GREEN, TEST_BRIGHTNESS);
        settings.mySettings.corner_color = cornercolorold;
        break;

      case MODE_BLUE:
#ifdef DEBUG
        if ( ModeSequenz == 1 ) Serial.println(F("************ Mode blau"));
#endif
#ifdef AUDIO_SOUND
        AUDIO_FILENR = ANSAGEBASE + 45; //Alles blau
        if ( ModeSequenz == 2 && !mode_ohne_sound ) {
          Play_MP3(AUDIO_FILENR, false, 0);
        }
#endif
        cornercolorold = settings.mySettings.corner_color;
        settings.mySettings.corner_color = BLUE;
        writeScreenBuffer(matrix, BLUE, TEST_BRIGHTNESS);
        settings.mySettings.corner_color = cornercolorold;
        break;

      case MODE_WHITE:
#ifdef DEBUG
        if ( ModeSequenz == 1 ) Serial.println(F("************ Mode weiss"));
#endif
#ifdef AUDIO_SOUND
        AUDIO_FILENR = ANSAGEBASE + 46;  //Alles weiss
        if ( ModeSequenz == 2 && !mode_ohne_sound ) {
          Play_MP3(AUDIO_FILENR, false, 0);
        }
#endif
        cornercolorold = settings.mySettings.corner_color;
        settings.mySettings.corner_color = WHITE;
        writeScreenBuffer(matrix, WHITE, TEST_BRIGHTNESS);
        settings.mySettings.corner_color = cornercolorold;
        break;

#endif
      case MODE_IP:
#ifdef DEBUG
        if ( ModeSequenz == 1 ) Serial.println(F("************ Mode IP"));
#endif
        if ( b_showip && webServer.client().status() > 0 ) 
        { 
          b_showip = false;
          setMode(MODE_TIME);
        }
      case MODE_FEED:
        writeScreenBuffer(matrix, feedColor, brightness);
        break;
      case MODE_SHOWANIMATION:
        if ( !showAnimation(brightness) )
        {
          akt_aniframe = 0;
          akt_aniloop = 0;
          screenBufferNeedsUpdate = true;
        }
        break;
      case MODE_MAKEANIMATION:
        showMakeAnimation(brightness);
        break;
      case MODE_ALARMANIMATION:
        if ( !showAnimation(brightness) )
        {
          akt_aniframe = 0;
          akt_aniloop = 0;
          setMode(MODE_TIME);
        }
        break;
      default:
        if (runTransitionOnce)
        {
          writeScreenBuffer(matrix, settings.mySettings.color, brightness);
          runTransitionOnce = false;
          testColumn = 0;
        }
        else
          writeScreenBuffer(matrix, settings.mySettings.color, brightness);
        break;
    }
    ldr_update = false;
  }

  // Wait for mode timeout then switch back to time

  if ((millis() > (modeExtraTime + modeTimeout + SHOW_MODE_TIMEOUT)) && modeTimeout )
  {

    ModeSequenz = 0;
    if ( mode < MODE_SECONDS && !single_mode ) {
      setMode(mode++);
    }
    else
    {
#ifdef DEBUG
      Serial.println(F("Mode TIME"));
#endif
      settings.mySettings.color = colorsaver;
#ifdef DEBUG
      Serial.printf("Color changed to: %u\r\n", settings.mySettings.color);
#endif
      setMode(MODE_TIME);
      mode_ohne_sound = false;
      single_mode = false;
    }
#ifdef DEBUG
    Serial.printf("Mode: %i\n", mode);
#endif
  }

#ifdef DEBUG_FPS
  debugFps();
#endif

  delay(5);
  // Call HTTP- and OTA-handle
  handle_Webserver(__LINE__);
  delay(5);
  ArduinoOTA.handle();

} // loop()

//*****************************************************************************
//*************************** ENDE LOOP ***************************************
//*****************************************************************************

/******************************************************************************
  Transitions
******************************************************************************/

void moveScreenBufferUp(uint16_t screenBufferOld[], uint16_t screenBufferNew[], uint8_t color, uint8_t brightness)
{
  for (uint8_t z = 0; z <= 9; z++)
  {
    ledDriver.clear();
    for (uint8_t i = 0; i <= 9; i++)
    {
      if ( i == 9 )
      {
        screenBufferOld[i] = screenBufferNew[z] & 0b1111111111100000;
      }
      else
      {
        screenBufferOld[i] = screenBufferOld[i + 1] & 0b1111111111100000;
      }
      for (uint8_t x = 0; x <= 10; x++)
      {
        if ( 8 - z >= i ) {
          if (bitRead(screenBufferOld[i], 15 - x)) ledDriver.setPixel(x, i, colorold, brightness);
        }
        else
        {
          if (bitRead(screenBufferOld[i], 15 - x)) ledDriver.setPixel(x, i, color, brightness);
        }
      }
    }
    ledDriver.show();
    handle_Webserver(__LINE__);
    delay(TRANSITION_SPEED);
  }
  writeScreenBuffer(screenBufferNew, color, brightness);
}

void moveScreenBufferDown(uint16_t screenBufferOld[], uint16_t screenBufferNew[], uint8_t color, uint8_t brightness)
{
  for (int z = 9; z >= 0; z--)
  {
    ledDriver.clear();
    for (int i = 9; i >= 0; i--)
    {
      if ( i == 0 )
      {
        screenBufferOld[i] = screenBufferNew[z] & 0b1111111111100000;
      }
      else
      {
        screenBufferOld[i] = screenBufferOld[i - 1] & 0b1111111111100000;
      }
      for (uint8_t x = 0; x <= 10; x++)
      {
        if ( 8 - z >= i ) {
          if (bitRead(screenBufferOld[i], 15 - x)) ledDriver.setPixel(x, i, color, brightness);
        }
        else
        {
          if (bitRead(screenBufferOld[i], 15 - x)) ledDriver.setPixel(x, i, colorold, brightness);
        }
      }
    }
    ledDriver.show();
    handle_Webserver(__LINE__);
    delay(TRANSITION_SPEED);
  }
  writeScreenBuffer(screenBufferNew, color, brightness);
}

void moveScreenBufferLeft(uint16_t screenBufferOld[], uint16_t screenBufferNew[], uint8_t color, uint8_t brightness)
{
  uint16_t m_old[10] = {};
  uint16_t m_new[10] = {};
  for (uint8_t ze = 0; ze <= 9; ze++)
  {
    m_old[ze] = screenBufferOld[ze];
    m_new[ze] = screenBufferNew[ze];
  }
  for (uint8_t z = 0; z <= 10; z++)
  {
    ledDriver.clear();
    for (uint8_t i = 0; i <= 9; i++)
    {
      m_old[i] = (( m_old[i] & 0b1111111111100000 ) << 1  | (( m_new[i] >> 10 ) & 0b0000000000100000 )) & 0b1111111111100000;
      m_new[i] = (m_new[i] << 1) & 0b1111111111100000;

      for (uint8_t x = 0; x <= 10; x++)
      {
        if ( x > 9 - z  )
        {
          if (bitRead(m_old[i], 15 - x)) ledDriver.setPixel(x, i, color, brightness);
        }
        else
        {
          if (bitRead(m_old[i], 15 - x)) ledDriver.setPixel(x, i, colorold, brightness);
        }
      }
    }
    ledDriver.show();
    handle_Webserver(__LINE__);
    delay(TRANSITION_SPEED);
  }
  writeScreenBuffer(screenBufferNew, color, brightness);
}

void moveScreenBufferRight(uint16_t screenBufferOld[], uint16_t screenBufferNew[], uint8_t color, uint8_t brightness)
{
  uint16_t m_old[10] = {};
  uint16_t m_new[10] = {};
  for (uint8_t ze = 0; ze <= 9; ze++)
  {
    m_old[ze] = screenBufferOld[ze];
    m_new[ze] = screenBufferNew[ze];
  }
  for (uint8_t z = 0; z <= 10; z++)
  {
    ledDriver.clear();
    for (uint8_t i = 0; i <= 9; i++)
    {
      m_old[i] = (m_old[i] >> 1 | m_new[i] << 10) & 0b1111111111100000;
      m_new[i] = (m_new[i] >> 1) & 0b1111111111100000;

      for (uint8_t x = 0; x <= 10; x++)
      {
        if ( x > z  )
        {
          if (bitRead(m_old[i], 15 - x)) ledDriver.setPixel(x, i, colorold, brightness);
        }
        else
        {
          if (bitRead(m_old[i], 15 - x)) ledDriver.setPixel(x, i, color, brightness);
        }
      }
    }
    ledDriver.show();
    handle_Webserver(__LINE__);
    delay(TRANSITION_SPEED);
  }
  writeScreenBuffer(screenBufferNew, color, brightness);
}

void moveScreenBufferLeftDown(uint16_t screenBufferOld[], uint16_t screenBufferNew[], uint8_t color, uint8_t brightness)
{
  for (int z = 0; z <= 9; z++)
  {
    ledDriver.clear();
    for (int i = 0; i <= 8 ; i++)
    {
      screenBufferOld[9 - i] = (screenBufferOld[8 - i] & 0b1111111111100000) << 1;
    }
    for (int i = 0; i <= z ; i++)
    {
      screenBufferOld[i] = ((screenBufferNew[9 + i - z] >> (14 - z)) << 5) & 0b1111111111100000;
    }

    for (int y = 0; y <= 9; y++)
    {
      for (uint8_t x = 0; x <= 10; x++)
      {
        if ( y <= z ) {
          if (bitRead(screenBufferOld[y], 15 - x)) ledDriver.setPixel(x, y, color, brightness);
        }
        else
        {
          if (bitRead(screenBufferOld[y], 15 - x)) ledDriver.setPixel(x, y, colorold, brightness);
        }
      }
    }

    ledDriver.show();
    handle_Webserver(__LINE__);
    delay(TRANSITION_SPEED);
  }
  writeScreenBuffer(screenBufferNew, color, brightness);
}

void moveScreenBufferRightDown(uint16_t screenBufferOld[], uint16_t screenBufferNew[], uint8_t color, uint8_t brightness)
{
  for (int z = 0; z <= 9; z++)
  {
    ledDriver.clear();
    for (int i = 0; i <= 8 ; i++)
    {
      screenBufferOld[9 - i] = screenBufferOld[8 - i] >> 1 & 0b1111111111100000;
    }
    for (int i = 0; i <= z ; i++)
    {
      screenBufferOld[i] = (screenBufferNew[9 + i - z] << (9 - z)) & 0b1111111111100000;
    }

    for (int y = 0; y <= 9; y++)
    {
      for (uint8_t x = 0; x <= 10; x++)
      {
        if ( y <= z ) {
          if (bitRead(screenBufferOld[y], 15 - x)) ledDriver.setPixel(x, y, color, brightness);
        }
        else
        {
          if (bitRead(screenBufferOld[y], 15 - x)) ledDriver.setPixel(x, y, colorold, brightness);
        }
      }
    }

    ledDriver.show();
    handle_Webserver(__LINE__);
    delay(TRANSITION_SPEED);
  }
  writeScreenBuffer(screenBufferNew, color, brightness);
}

void moveScreenBufferCenter(uint16_t screenBufferOld[], uint16_t screenBufferNew[], uint8_t color, uint8_t brightness)
{
  uint16_t mask[5] = {};
  mask[0] = 0b1000000000100000;
  mask[1] = 0b1100000001100000;
  mask[2] = 0b1110000011100000;
  mask[3] = 0b1111000111100000;
  mask[4] = 0b1111101111100000;
  uint16_t m_old[10] = {};
  uint16_t m_new[10] = {};
  for (uint8_t ze = 0; ze <= 9; ze++)
  {
    m_old[ze] = screenBufferOld[ze] & 0b1111111111100000;
    m_new[ze] = screenBufferNew[ze];
  }
  //##################### Old zur Mitte #########################################
  for (int i = 0; i <= 4; i++)
  {
    for (int z = 0; z <= 4; z++)
    {
      m_old[z] = ((m_old[z] & 0b1111110000000000) >> 1) | ((m_old[z] & 0b0000001111110000) << 1);
      m_old[9 - z] = ((m_old[9 - z] & 0b1111110000000000) >> 1) | ((m_old[9 - z] & 0b0000001111110000) << 1);
    }
    for (int z = 0; z <= 3; z++)
    {
      m_old[z + 5] = m_old[z + 6];
      m_old[4 - z] = m_old[3 - z];
    }
    m_old[9] = 0;
    m_old[0] = 0;
    writeScreenBuffer(m_old, colorold, brightness);
    handle_Webserver(__LINE__);
    delay(TRANSITION_SPEED);
  }
  //###################### New aus der Mitte ########################################
  for (int i = 4; i >= 0 ; i--)
  {
    for (int z = 0; z <= 4 - i; z++)
    {
      m_old[i + z] =   ((m_new[z]  & mask[4 - i]) >> (i + 1) & 0b1111110000000000) | ((m_new[z]  & mask[4 - i]) << (i + 1) & 0b0000011111100000);
      m_old[9 - i - z] = ((m_new[9 - z] & mask[4 - i]) >> (i + 1) & 0b1111110000000000) | ((m_new[9 - z] & mask[4 - i]) << (i + 1) & 0b0000011111100000);
    }
    writeScreenBuffer(m_old, color, brightness);
    handle_Webserver(__LINE__);
    delay(TRANSITION_SPEED);
  }

  handle_Webserver(__LINE__);
  writeScreenBuffer(screenBufferNew, color, brightness);
}




void matrix_regen(uint16_t screenBufferOld[], uint16_t screenBufferNew[], uint8_t color, uint8_t brightness)
{
  uint16_t mline[11] = {0};
  uint16_t wline[11] = {0};
  uint16_t sline[11] = {0};
  uint8_t aktline;
  uint16_t mleer = 0;  // zu prüfen ob wir fertig sind

  uint8_t mstep = 0;
  uint16_t mline_max[11] = {0};
  uint16_t brightnessBuffer[11][12] = {0};
  uint16_t brightness_16 = brightness;

  uint16_t zufallszeile[11] = {0, 1, 2, 3, 4, 5, 6, 7, 8, 9, 10};
  uint16_t zufallsbuffer;
  uint16_t zufallsindex;
  // Zufälliges Vertauschen von jeweils 2 Zeilenwerten:
  for (uint8_t i = 0; i <= 10; i++)
  {
    zufallsindex = random(0, 11);
    zufallsbuffer = zufallszeile[zufallsindex];
    zufallszeile[zufallsindex] = zufallszeile[i];
    zufallszeile[i] = zufallsbuffer;

  }
  // Variablen init
  for (uint8_t line = 0; line <= 10; line++)
  {
    sline[line] = (11 - (zufallszeile[line] % 11 )) * 5 / 2;
    mline_max[line] = 0;
    mline[line] = 0;
    wline[line] = 0;
  }

  for (uint16_t i = 0; i <= 1200; i++)
  {
    aktline = zufallszeile[i % 11];

    if ( sline[aktline] > 0 ) sline[aktline]--;
    if ( sline[aktline] == 0 )
    {
      sline[aktline] = 3 - (aktline % 2);

      if ( mline[aktline] == 0 && mline_max[aktline] < 10)
      {
        mline[aktline] = 1;
        mline_max[aktline]++;
      }
      else
      {
        if ( mline_max[aktline] < 11 )  // solange grün hinzu bis unten erreicht ist
        {
          if ( random(0, 6) == 0 && (mline[aktline] & 1) == 0 )
          {
            mline[aktline] = mline[aktline] << 1;
            mline[aktline] = mline[aktline] | 1;
            wline[aktline] = wline[aktline] << 1;
          }
          else
          {
            wline[aktline] = wline[aktline] << 1;
            wline[aktline] = wline[aktline] | 1;
            mline[aktline] = mline[aktline] << 1;
          }
          mline_max[aktline]++;
        }
        else
        {
          mline[aktline] = mline[aktline] << 1;
          wline[aktline] = wline[aktline] << 1;
          if ( (mline[aktline] & 0x3FF)  == 0 && (wline[aktline] & 0x3FF) == 0 ) mleer = mleer | 1 << aktline;
        }
      }
      ledDriver.clear();
      for ( uint16_t y = 0; y <= 9; y++ )
      {
        for ( uint16_t x = 0; x <= 10; x++ )
        {
          if ( y > mline_max[x] - 1 )
          {
            if (bitRead(screenBufferOld[y], 15 - x)) ledDriver.setPixel(x, y, colorold, brightness);
          }
          else
          {
            if (bitRead(screenBufferNew[y], 15 - x)) ledDriver.setPixel(x, y, color, brightness);
          }
          brightnessBuffer[y][x] = 0;
          if ( wline[x] & (1 << y) )
          {
            brightnessBuffer[y][x] = brightness_16 / 9;
            //             brightnessBuffer[y][x] = brightness_16 / 8 - ( brightness_16 / ( 10 * (mline_max[x]-1 - y))) ;
            if ( brightnessBuffer[y][x] < 3) brightnessBuffer[y][x] = 2;
          }
          if ( mline[x] & (1 << y) )
          {
            brightnessBuffer[y][x] =  brightness_16 * 10 / 9;
            if ( brightnessBuffer[y][x] > 254 ) brightnessBuffer[y][x] = 255;
          }

          if ( brightnessBuffer[y][x] > 0 )
          {
            ledDriver.setPixel(x, y, GREEN, brightnessBuffer[y][x]);
          }
        } // x
      }  // y
      ledDriver.show();
      delay (int(TRANSITION_SPEED / 9));
      delay (1);
    }
    handle_Webserver(__LINE__);
    if ( i > 100 && mleer == 0x7FF) break;
  }

  writeScreenBuffer(screenBufferNew, color, brightness);
  colorold = color;
}

void moveSeriell(uint16_t screenBufferOld[], uint16_t screenBufferNew[], uint8_t color, uint8_t brightness, uint8_t sertype)
{
  uint16_t pointerbuffer;
  uint16_t xold_dest;
  uint16_t yold_dest;
  uint16_t xold_source;
  uint16_t yold_source;
  uint16_t xnew_dest;
  uint16_t ynew_dest;
  uint16_t xnew_source;
  uint16_t ynew_source;
  int s_old;
  int c;
  int s_new;

  int aquad;
  int adelay;

  for (int a = 0; a <= 109; a++)
  {
    ledDriver.clear();
    for (int b = 0; b <= 109; b++)
    {
      s_old = a + b + 1;
      pointerbuffer = pgm_read_word(&seriellpointer[sertype][b]);
      xold_dest = pointerbuffer % 11;         //seriellpointer ist in Modes.h definiert
      yold_dest = pointerbuffer / 11;
      pointerbuffer = pgm_read_word(&seriellpointer[sertype][s_old]);
      xold_source = pointerbuffer % 11;
      yold_source = pointerbuffer / 11;

      c = 109 - b;
      s_new = a - c;

      xnew_dest = xold_dest;
      ynew_dest = yold_dest;
      pointerbuffer = pgm_read_word(&seriellpointer[sertype][s_new]);
      xnew_source = pointerbuffer % 11;
      ynew_source = pointerbuffer / 11;

      if (  c > a )
      {
        if (bitRead(screenBufferOld[yold_source], 15 - xold_source)) ledDriver.setPixel(xold_dest, yold_dest, colorold, brightness);
      }
      else
      {
        if (bitRead(screenBufferNew[ynew_source], 15 - xnew_source)) ledDriver.setPixel(xnew_dest, ynew_dest, color, brightness);
      }
    }

    ledDriver.show();
    handle_Webserver(__LINE__);
    aquad = (130 - a) * (130 - a); // damit wir am Ende quadratisch immer langsamer werden
    //    delay(2*TRANSITION_SPEED/(1+((120-a)/10)));
    adelay = 5 + ( 360 * TRANSITION_SPEED / aquad);
    delay(adelay);
  }
  writeScreenBuffer(screenBufferNew, color, brightness);
  colorold = color;
}

void farbenmeer(uint16_t screenBufferOld[], uint16_t screenBufferNew[], uint8_t color, uint8_t brightness)
{
  uint16_t zufallszeile[10] = {0, 1, 2, 3, 4, 5, 6, 7, 8, 9};
  uint16_t zufallsbuffer;
  uint16_t zufallsspalte[11] = {0, 1, 2, 3, 4, 5, 6, 7, 8, 9, 10};
  //  uint16_t zufallsspalte[11] = {0x20,0x40,0x80,0x100,0x200,0x400,0x800,0x1000,0x2000,0x4000,0x8000};
  uint16_t zufallsindex;
  // Zufälliges Vertauschen von jeweils 2 Zeilenwerten:
  for (uint8_t i = 0; i <= 9; i++)
  {
    zufallsindex = random(0, 10);
    zufallsbuffer = zufallszeile[zufallsindex];
    zufallszeile[zufallsindex] = zufallszeile[i];
    zufallszeile[i] = zufallsbuffer;
  }
  // Zufälliges Vertauschen von jeweils 2 Spaltennwerten:
  for (uint8_t i = 0; i <= 10; i++)
  {
    zufallsindex = random(0, 11);
    zufallsbuffer = zufallsspalte[zufallsindex];
    zufallsspalte[zufallsindex] = zufallsspalte[i];
    zufallsspalte[i] = zufallsbuffer;
  }
  // Farben füllen
  for (uint8_t x = 0; x <= 10; x++)
  {
    for (uint8_t y = 0; y <= 9; y++)
    {
      zufallsindex = y + x;
      if ( zufallsindex > 10) zufallsindex = zufallsindex - 11;
      screenBufferOld[zufallszeile[y]] = screenBufferOld[zufallszeile[y]] | zufallsspalte[zufallsindex];
      ledDriver.setPixel(zufallsspalte[zufallsindex], zufallszeile[y], random(1, COLOR_COUNT + 1) , brightness);
      ledDriver.show();
      handle_Webserver(__LINE__);
      if ( wortuhrinit ) {
        delay (60 - 5 * x);
      }
      else
      {
        delay (11 - x);
      }
    }
  }
  // Farben leeren
  for (uint8_t x = 0; x <= 10; x++)
  {
    for (uint8_t y = 0; y <= 9; y++)
    {
      zufallsindex = y + x;
      if ( zufallsindex > 10) zufallsindex = zufallsindex - 11;
      if ( bitRead(screenBufferNew[zufallszeile[y]], 15 - zufallsspalte[zufallsindex]))
      {
        ledDriver.setPixel(zufallsspalte[zufallsindex], zufallszeile[y], color , brightness);
      }
      else
      {
        ledDriver.setPixel(zufallsspalte[zufallsindex], zufallszeile[y], color , 0);
      }
      ledDriver.show();
      handle_Webserver(__LINE__);
      if ( wortuhrinit ) {
        delay (5 + 4 * x);
      }
      else
      {
        delay (1 + x);
      }

    }
  }
  writeScreenBuffer(screenBufferNew, color, brightness);
  colorold = color;
}


void regenbogen(uint16_t screenBufferOld[], uint16_t screenBufferNew[], uint8_t color, uint8_t brightness)
{
  int startbogen = 0;
  int bogenidx = 0;

  uint8_t bogen[10][12] = {
    {0      , 0      , 0      , 0      , RED    , RED    , RED    , 0      , 0      , 0      , 0     },
    {0      , RED    , RED    , RED    , ORANGE , ORANGE , ORANGE , RED    , RED    , RED    , 0     },
    {RED    , ORANGE , ORANGE , ORANGE , YELLOW , YELLOW , YELLOW , ORANGE , ORANGE , ORANGE , RED   },
    {ORANGE , YELLOW , YELLOW , YELLOW , GREEN  , GREEN  , GREEN  , YELLOW , YELLOW , YELLOW , ORANGE},
    {YELLOW , GREEN  , GREEN  , GREEN  , BLUE   , BLUE   , BLUE   , GREEN  , GREEN  , GREEN  , YELLOW},
    {GREEN  , BLUE   , BLUE   , BLUE   , MAGENTA, MAGENTA, MAGENTA, BLUE   , BLUE   , BLUE   , GREEN },
    {BLUE   , MAGENTA, MAGENTA, MAGENTA, 99     , 99     , 99     , MAGENTA, MAGENTA, MAGENTA, BLUE  },
    {MAGENTA, 99     , 99     , 99     , 99     , 99     , 99     , 99     , 99     , 99     , MAGENTA},
    {99     , 99     , 99     , 99     , 99     , 99     , 99     , 99     , 99     , 99     , 99},
    {99     , 99     , 99     , 99     , 99     , 99     , 99     , 99     , 99     , 99     , 99    }
  };

  for (uint8_t d = 0; d < 19; d++)
  {
    ledDriver.clear();
    for (uint8_t y = 0; y <= 9; y++)
    {
      startbogen = 9 - d;
      bogenidx = y - startbogen;
      if ( startbogen < 0 ) startbogen = 0;
      for (uint8_t x = 0; x <= 10; x++)
      {
        if (bitRead(screenBufferOld[y], 15 - x)) ledDriver.setPixel(x, y, colorold, brightness);
        if ( y >= startbogen && bogenidx >= 0 && bogenidx <= 9)                                                                // Regenbogenbereich
        {
          if ( bogen[bogenidx][x] != 0 && bogen[bogenidx][x] != 99 ) ledDriver.setPixel(x, y, bogen[bogenidx][x], brightness); // Farbe aus Regenbogen
          if ( bogen[bogenidx][x] == 99 )                                                                                      // Prüfen ob hier kein Regenbogen ist
          {
            if (bitRead(screenBufferNew[y], 15 - x)) ledDriver.setPixel(x, y, color, brightness);                              // Farbe aus color (neue Farbe)
            else ledDriver.setPixel(x, y, color, 0);                                                                           // Pixel löschen (brightness = 0)
          }
        }
        if ( y >= startbogen && bogenidx > 9 )                                                                         // Regenbogen ist vorbei
        {
          if (bitRead(screenBufferNew[y], 15 - x)) ledDriver.setPixel(x, y, color, brightness);                        // Neues Pixel gesetzt dann neue Farbe
          else ledDriver.setPixel(x, y, color, 0);                                                                     // ansonsten Pixel löschen (brightness = 0)
        }
      }
    }
    ledDriver.show();
    handle_Webserver(__LINE__);
    delay(TRANSITION_SPEED * 15 / 10);
  }
  writeScreenBuffer(screenBufferNew, color, brightness);
  colorold = color;
}

//#########################
// Kreise
//
// kreistoBuffer
// legt einen Kreis und die innere Kreisfläche jeweils in eine matrix
// x0: x-Koordinate 0-10 (0=links 10=rechts)
// y0: y-Koordinate 0-9 (0=oben 9=unten)
// r: Radius
// Rückgabe: true wenn Kreis innerhalb der Matrix ist. false wenn nicht.
bool kreistoBuffer(uint16_t kreislinie[], uint16_t kreisflaeche[], int8_t x0, int8_t y0, int8_t r)
{
  int8_t maxy = 10;
  int8_t maxx = 11;
  int8_t f = 1 - r;
  int8_t ddF_x = 1;
  int8_t ddF_y = -2 * r;
  int8_t x = 0;
  int8_t y = r;
  uint16_t matrix[10] = {};
  uint16_t matrixf[10] = {};
  uint16_t mask = 0b1111111111100000;
  uint16_t tst = 0;

  bool retval = false;

  for (uint8_t ze = 0; ze <= 9; ze++)
  {
    matrix[ze] = 0;
    matrixf[ze] = mask;
  }

  if ( y0 >= 0 && y0 < maxy && x0 + r >= 0 && x0 + r < maxx) matrix[y0]   = (matrix[y0] | 1 << (15 - x0 - r))& mask;
  if ( y0 >= 0 && y0 < maxy && x0 - r >= 0 && x0 - r < maxx) matrix[y0]   = (matrix[y0] | 1 << (15 - x0 + r))& mask;
  if ( y0 + r >= 0 && y0 + r < maxy && x0 >= 0 && x0 < maxx) matrix[y0 + r] = (matrix[y0 + r] | 1 << (15 - x0))& mask;
  if ( y0 - r >= 0 && y0 - r < maxy && x0 >= 0 && x0 < maxx) matrix[y0 - r] = (matrix[y0 - r] | 1 << (15 - x0))& mask;

  if ( y0 >= 0 && y0 < maxy )
  {
    matrixf[y0] = mask >> (x0 + r);
    matrixf[y0] = matrixf[y0] | mask << (maxx - 1 - x0 + r);
  }

  while (x < y) {
    if (f >= 0) {
      y--;
      ddF_y += 2;
      f += ddF_y;
    }
    x++;
    ddF_x += 2;
    f += ddF_x;

    if ( y0 + y >= 0 && y0 + y < maxy && x0 + x >= 0 && x0 + x < maxx) matrix[y0 + y] = (matrix[y0 + y] | 1 << (15 - x0 - x))&mask;
    if ( y0 + y >= 0 && y0 + y < maxy && x0 - x >= 0 && x0 - x < maxx) matrix[y0 + y] = (matrix[y0 + y] | 1 << (15 - x0 + x))&mask;
    if ( y0 - y >= 0 && y0 - y < maxy && x0 + x >= 0 && x0 + x < maxx) matrix[y0 - y] = (matrix[y0 - y] | 1 << (15 - x0 - x))&mask;
    if ( y0 - y >= 0 && y0 - y < maxy && x0 - x >= 0 && x0 - x < maxx) matrix[y0 - y] = (matrix[y0 - y] | 1 << (15 - x0 + x))&mask;
    if ( y0 + x >= 0 && y0 + x < maxy && x0 + y >= 0 && x0 + y < maxx) matrix[y0 + x] = (matrix[y0 + x] | 1 << (15 - x0 - y))&mask;
    if ( y0 + x >= 0 && y0 + x < maxy && x0 - y >= 0 && x0 - y < maxx) matrix[y0 + x] = (matrix[y0 + x] | 1 << (15 - x0 + y))&mask;
    if ( y0 - x >= 0 && y0 - x < maxy && x0 + y >= 0 && x0 + y < maxx) matrix[y0 - x] = (matrix[y0 - x] | 1 << (15 - x0 - y))&mask;
    if ( y0 - x >= 0 && y0 - x < maxy && x0 - y >= 0 && x0 - y < maxx) matrix[y0 - x] = (matrix[y0 - x] | 1 << (15 - x0 + y))&mask;

    if ( y0 + x >= 0 && y0 + x < maxy )
    {
      matrixf[y0 + x] = mask >> (x0 + y);
      matrixf[y0 + x] = matrixf[y0 + x] | mask << (maxx - 1 - x0 + y);
    }
    if ( y0 - x >= 0 && y0 - x < maxy )
    {
      matrixf[y0 - x] = mask >> (x0 + y);
      matrixf[y0 - x] = matrixf[y0 - x] | mask << (maxx - 1 - x0 + y);
    }

    if ( y0 + y >= 0 && y0 + y < maxy )
    {
      matrixf[y0 + y] = mask >> (x0 + x);
      matrixf[y0 + y] = matrixf[y0 + y] | mask << (maxx - 1 - x0 + x);
    }
    if ( y0 - y >= 0 && y0 - y < maxy )
    {
      matrixf[y0 - y] = mask >> (x0 + x);
      matrixf[y0 - y] = matrixf[y0 - y] | mask << (maxx - 1 - x0 + x);
    }
  }

  for (uint8_t ze = 0; ze <= 9; ze++)
  {
    kreislinie[ze] = matrix[ze];
    if ( kreislinie[ze] > 0 ) retval = true;
    kreisflaeche[ze] = (~(matrixf[ze] | matrix[ze])) & mask;
  }
  return retval;
}
void kreise (uint16_t screenBufferOld[], uint16_t screenBufferNew[], uint8_t color, uint8_t brightness)
{

  uint16_t xbuff;
  uint16_t m_old[10] = {};
  uint16_t m_new[10] = {};

  uint16_t kreis1[10] = {};
  uint16_t kreis1fl[10] = {};
  bool work1 = true;
  uint8_t mp1x = random(2, 6);
  uint8_t mp1y = random(2, 6);
  uint8_t r1 = 0;

  uint16_t kreis2[10] = {};
  uint16_t kreis2fl[10] = {};
  bool work2 = false;
  uint8_t mp2x = random(5, 10);
  uint8_t mp2y = random(5, 9);
  uint8_t r2 = 0;

  uint16_t kreis3[10] = {};
  uint16_t kreis3fl[10] = {};
  bool work3 = false;
  uint8_t mp3x = random(3, 8);
  uint8_t mp3y = random(2, 7);
  uint8_t r3 = 0;

  uint8_t uhrcolor = colorold;

  // Init
  for (uint8_t ze = 0; ze <= 9; ze++)
  {
    m_old[ze] = screenBufferOld[ze];
    m_new[ze] = screenBufferNew[ze];
  }
  handle_Webserver(__LINE__);
  while (work1 || work2 || work3)
  {
    ledDriver.clear();
    if ( work1) work1 = kreistoBuffer(kreis1, kreis1fl, mp1x, mp1y, r1);
    if ( work2) work2 = kreistoBuffer(kreis2, kreis2fl, mp2x, mp2y, r2);
    if ( work3) work3 = kreistoBuffer(kreis3, kreis3fl, mp1x, mp3y, r3);


    for (uint8_t y = 0; y <= 9; y++)
    {
      if (work3)
      {
        xbuff = (m_new[y] & kreis3fl[y]);
        uhrcolor = color;
      }
      else
      {
        xbuff = (m_old[y] & ~kreis1fl[y]);
      }
      if (!(work1 || work2 || work3) ) xbuff = m_new[y];

      for (uint8_t x = 0; x <= 10; x++)
      {
        if (bitRead( xbuff, 15 - x )) ledDriver.setPixel(x, y, uhrcolor, brightness);
        if (work1 && bitRead( kreis1[y], 15 - x )) ledDriver.setPixel(x, y, WHITE, brightness);
        if (work2 && bitRead( kreis2[y], 15 - x )) ledDriver.setPixel(x, y, WHITE, brightness);
        if (work3 && bitRead( kreis3[y], 15 - x )) ledDriver.setPixel(x, y, WHITE, brightness);
      }
    }

    if ( work1) r1++;
    if ( work2) r2++;
    if ( work3) r3++;
    if ( r2 == 0 && r1 > abs(mp1x - mp2x) + 1 && r1 > abs(mp1y - mp2y) + 1)
    {
      work2 = true;
      handle_Webserver(__LINE__);
    }
    if ( r3 == 0 && r2 > abs(mp2x - mp3x) + 1 && r2 > abs(mp2y - mp3y) + 1)
    {
      work3 = true;
      handle_Webserver(__LINE__);
    }

    ledDriver.show();
    delay(TRANSITION_SPEED + 10);
  }
  handle_Webserver(__LINE__);
  writeScreenBuffer(screenBufferNew, color, brightness);
  colorold = color;
}
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
