manfred-hofmann/Wortuhr_ESP8266/src/html_content.h

//******************************************************************************
// html_content.h
//******************************************************************************

#ifndef HTML_CONTENT_H
#define HTML_CONTENT_H

#define IMAGE_GIF "image/gif"
#define IMAGE_PNG "image/png"
#define TEXT_HTML "text/html"
#define TEXT_CSS "text/css"
#define TEXT_PLAIN "text/plain"

//#############################################################################################
// sunrise.png
const static uint8_t p_sunrise[] PROGMEM = {
0x89, 0x50, 0x4E, 0x47, 0x0D, 0x0A, 0x1A, 0x0A, 0x00, 0x00, 0x00, 0x0D, 0x49, 0x48, 0x44, 0x52, 
0x00, 0x00, 0x00, 0x80, 0x00, 0x00, 0x00, 0x80, 0x08, 0x06, 0x00, 0x00, 0x00, 0xC3, 0x3E, 0x61, 
0xCB, 0x00, 0x00, 0x00, 0x01, 0x73, 0x52, 0x47, 0x42, 0x00, 0xAE, 0xCE, 0x1C, 0xE9, 0x00, 0x00, 
0x00, 0x04, 0x67, 0x41, 0x4D, 0x41, 0x00, 0x00, 0xB1, 0x8F, 0x0B, 0xFC, 0x61, 0x05, 0x00, 0x00, 
0x00, 0x09, 0x70, 0x48, 0x59, 0x73, 0x00, 0x00, 0x0E, 0xC3, 0x00, 0x00, 0x0E, 0xC3, 0x01, 0xC7, 
0x6F, 0xA8, 0x64, 0x00, 0x00, 0x39, 0x76, 0x49, 0x44, 0x41, 0x54, 0x78, 0x5E, 0xDD, 0x7D, 0x09, 
0xB4, 0xA4, 0xD7, 0x51, 0xDE, 0xFD, 0xBB, 0xDF, 0x3A, 0x6F, 0x99, 0x7D, 0xD1, 0x48, 0x33, 0xA3, 
0x19, 0x69, 0x90, 0x6D, 0x59, 0x02, 0xCC, 0x16, 0xB0, 0x01, 0x3B, 0x18, 0x61, 0x30, 0x8B, 0xCD, 
0xC1, 0x72, 0xB0, 0x09, 0x21, 0x38, 0x1C, 0x48, 0xC8, 0xC1, 0x60, 0x88, 0x4D, 0x58, 0x85, 0x7D, 
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
0xE7, 0x1B, 0xEB, 0x9B, 0x5D, 0xBF, 0xFF, 0xFF, 0xFF, 0x00, 0x06, 0x28, 0xE0, 0x80, 0x04, 0x16, 
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
};

//#############################################################################################


#endif
