manfred-hofmann/Wortuhr_ESP8266/src/Modes.h

//******************************************************************************
// Modes.h
//******************************************************************************

#ifndef MODES_H
#define MODES_H

typedef enum eMode : uint8_t
{
	MODE_TIME,				 // 0
#ifdef SHOW_MODE_ANSAGE
	MODE_ANSAGE,			 // 1
#endif
#ifdef SHOW_MODE_WEEKDAY
	MODE_WEEKDAY,			 // 2
#endif
#ifdef SHOW_MODE_DATE
  MODE_DATE,         // 3
#endif
#ifdef SHOW_MODE_MOONPHASE
	MODE_MOONPHASE,		 // 4
#endif
#if defined(RTC_BACKUP) || defined(SENSOR_BME280)
	MODE_TEMP,				 // 5
#endif
#ifdef SENSOR_BME280
	MODE_HUMIDITY,		 // 6
  MODE_LUFTDRUCK,    // 7
#endif
#ifdef APIKEY
  MODE_WETTER,       // 8 
	MODE_EXT_TEMP,		 // 9
	MODE_EXT_HUMIDITY, // 10
#endif
#ifdef SHOW_MODE_SECONDS
  MODE_SECONDS,      // 11 
#endif
#ifdef SHOW_MODE_TEST
  MODE_IP,           // 12
	MODE_TEST,				 // 13
	MODE_RED,				   // 14
	MODE_GREEN,				 // 15
	MODE_BLUE,				 // 16
	MODE_WHITE,				 // 17
#endif
#if defined(BUZZER) || defined(AUDIO_SOUND)
  MODE_TIMER,        // 18
#endif
	MODE_COUNT,				 // 19
	MODE_BLANK,				 // 20
	MODE_FEED,				 // 21
  MODE_SHOWANIMATION,  // 22
  MODE_MAKEANIMATION,  // 23
  MODE_ALARMANIMATION,  // 24
  MODE_GAME,            //25
  MODE_LAST             //26
} Mode;

// Overload the ControlType++ operator.
inline Mode& operator++(Mode& eDOW, int)
{
	const uint8_t i = static_cast<uint8_t>(eDOW) + 1;
	eDOW = static_cast<Mode>((i) % MODE_COUNT);
	return eDOW;
}

enum eTransition
{
  TRANSITION_NORMAL,        //0
  TRANSITION_FARBENMEER,    //1
  TRANSITION_MOVEUP,        //2
  TRANSITION_MOVEDOWN,      //3
  TRANSITION_MOVELEFT,      //4
  TRANSITION_MOVERIGHT,     //5
  TRANSITION_MOVELEFTDOWN,  //6
  TRANSITION_MOVERIGHTDOWN, //7
  TRANSITION_MOVECENTER,    //8
  TRANSITION_FADE,          //9
  TRANSITION_MATRIX,        //10
  TRANSITION_SPIRALE_LINKS, //11
  TRANSITION_SPIRALE_RECHTS,//12
  TRANSITION_ZEILENWEISE,   //13
  TRANSITION_REGENBOGEN,    //14
  TRANSITION_MITTE_LINKSHERUM, //15
  TRANSITION_QUADRATE,      //16
  TRANSITION_KREISE,        //17
  TRANSITION_MAX,           //18
  TRANSITION_PH1,           //19
  TRANSITION_ALLE_NACHEINANDER, //20
  TRANSITION_RANDOM         //21
};

enum SERTYPE
{
  SPIRALE_LINKS,      //0
  SPIRALE_RECHTS,     //1
  ZEILENWEISE,        //2
  MITTE_LINKSHERUM,   //3
  SPALTENWEISE,       //4
  QUER                //5
};

const uint16_t seriellpointer[][110] PROGMEM = 
{
     { //SPIRALE links
      0,1,2,3,4,5,6,7,8,9,10,21,32,43,54,65,76,87,98,109,
     108,107,106,105,104,103,102,101,100,99,88,77,66,55,44,33,22,11,
     12,13,14,15,15,17,18,19,20,31,42,53,64,75,86,97,
     96,95,94,93,92,91,90,89,78,67,56,45,34,23,
     24,25,26,27,28,29,30,41,52,63,74,85,
     84,83,82,81,80,79,68,57,46,35,
     36,37,38,39,40,51,62,73,72,71,70,69,
     58,47,48,49,50,61,60,59
     },
     { //SPIRALE rechts
       59, 60, 61, 50, 49, 48, 47, 58, 69, 70, 71, 72, 73, 62, 51, 40, 39, 38, 37, 36, 35, 46,
       57, 68, 79, 80, 81, 82, 83, 84, 85, 74, 63, 52, 41, 30, 29, 28, 27, 26, 25, 24, 23, 34,
       45, 56, 67, 78, 89, 90, 91, 92, 93, 94, 95, 96, 97, 85, 75, 64, 53, 42, 31, 20, 19, 18,
       17, 16, 15, 14, 13, 12, 11, 22, 33, 44, 55, 66, 77, 88, 99,100,101,102,103,104,105,106,
      107,108,109, 98, 87, 76, 65, 54, 43, 32, 21, 10,  9,  8,  7,  6,  5,  4,  3,  2,  1,  0
     },
     { //Zeilenweise
      0 ,1 ,2 ,3 ,4 ,5 ,6 ,7 ,8 ,9 ,10,21,20,19,18,17,16,15,14,13,12,11,
      22,23,24,25,26,27,28,29,30,31,32,43,42,41,40,39,38,37,36,35,34,33,
      44,45,46,47,48,49,50,51,52,53,54,65,64,63,62,61,60,59,58,57,56,55,
      66,67,68,69,70,71,72,73,74,75,76,87,86,85,84,83,82,81,80,79,78,77,
      88,89,90,91,92,93,94,95,96,97,98,109,108,107,106,105,104,103,102,101,100,99
     },
     { //MITTE_LINKSHERUM
      0,1,13,25,37,48, 2,14,26, 3,4,15, 5,16,27,38,49, 7,6,17,
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
        0b0000110000000000,
        0b0011100000000000,
        0b0111000000000000,
        0b0110000000000000,
        0b1110000000000000,
        0b1110000000000000,
        0b0110000000000000,
        0b0111000000000000,
        0b0011100000000000,
        0b0000110000000000
  },
    { // 20
        0b0000110000000000,
        0b0011000000000000,
        0b0110000000000000,
        0b0110000000000000,
        0b1100000000000000,
        0b1100000000000000,
        0b0110000000000000,
        0b0110000000000000,
        0b0011000000000000,
        0b0000110000000000
  },
    { // 21
        0b0000110000000000,
        0b0011000000000000,
        0b0100000000000000,
        0b0100000000000000,
        0b1000000000000000,
        0b1000000000000000,
        0b0100000000000000,
        0b0100000000000000,
        0b0011000000000000,
        0b0000110000000000
  },
    { // 22 Neumond
        0b0000101000000000,
        0b0010000010000000,
        0b0100000001000000,
        0b0000000000000000,
        0b1000000000100000,
        0b1000000000100000,
        0b0000000000000000,
        0b0100000001000000,
        0b0010000010000000,
        0b0000101000000000
  }
};
#endif
