manfred-hofmann/Wortuhr_ESP8266/src/Letters.h

/******************************************************************************
Letters.h
******************************************************************************/

#ifndef LETTERS_H
#define LETTERS_H


const char letters[][5] PROGMEM =
{
  { // 0:A
	0b00001100,
	0b00010010,
	0b00011110,
	0b00010010,
	0b00010010
  }
  , { // 1:B
	0b00011100,
	0b00010010,
	0b00011100,
	0b00010010,
	0b00011100
  }
  , { // 2:C
	0b00001110,
	0b00010000,
	0b00010000,
	0b00010000,
	0b00001110
  }
  , { // 3:D
	0b00011100,
	0b00010010,
	0b00010010,
	0b00010010,
	0b00011100
  }
  , { // 4:E
	0b00011110,
	0b00010000,
	0b00011100,
	0b00010000,
	0b00011110
  }
  , { // 5:F
	0b00011110,
	0b00010000,
	0b00011100,
	0b00010000,
	0b00010000
  }
  , { // 6:G
	0b00001110,
	0b00010000,
	0b00010110,
	0b00010010,
	0b00001100
  }
  , { // 7:H
	0b00010010,
	0b00010010,
	0b00011110,
	0b00010010,
	0b00010010
  }
  , { // 8:I
	0b00001110,
	0b00000100,
	0b00000100,
	0b00000100,
	0b00001110
  }
  , { // 9:J
	0b00011110,
	0b00000010,
	0b00000010,
	0b00010010,
	0b00001100
  }
  , { // 10:K
	0b00010010,
	0b00010100,
	0b00011000,
	0b00010100,
	0b00010010
  }
  , { // 11:L
	0b00010000,
	0b00010000,
	0b00010000,
	0b00010000,
	0b00011110
  }
  , { // 12:M
	0b00010001,
	0b00011011,
	0b00010101,
	0b00010001,
	0b00010001
  }
  , { // 13:N
	0b00010001,
	0b00011001,
	0b00010101,
	0b00010011,
	0b00010001
  }
  , { // 14:O
	0b00001100,
	0b00010010,
	0b00010010,
	0b00010010,
	0b00001100
  }
  , { // 15:P
	0b00011100,
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
  { 0x11, 0x0e, 0x11, 0x11, 0x11, 0x11, 0x0e }, // ASCII-Code 0x83 => Ö (131)
  { 0x11, 0x00, 0x0e, 0x11, 0x11, 0x11, 0x0e }, // ASCII-Code 0x84 => o (132)
  { 0x0c, 0x12, 0x14, 0x14, 0x12, 0x11, 0x12 }  // ASCII-Code 0x85 => ß (133)
};

#endif
