manfred-hofmann/Wortuhr_ESP8266/(commit log)

2021-10-20 Leeren des 4gewinnt Boards bei Spielende
2022-03-30 BugFix http-Request
    [Configuration.h]
2022-06-03 Update Mode Button
2022-11-04 BugFix Copy/Paste Frame
