manfred-hofmann/Wortuhr_ESP8266/(notices)

Notices in the files:
src/Wortuhr_mp3.ino:
This source file is free software: you can redistribute it and/or modify
it under the terms of the GNU General Public License as published
